lolheropro-arch/lab_ii_signal/mini_project/README.md

# Mini Shazam — ระบบจำเพลงจากเสียง (ESP32 + FPGA + Python)

ฟังเสียงเพลงจากไมค์ 5–10 วินาที แล้วบอกว่าเป็นเพลงอะไร และกำลังเล่นอยู่ที่นาทีไหนของเพลง
ใช้หลัก **Audio Fingerprinting** ตามเปเปอร์ของ Avery Wang (ผู้ร่วมก่อตั้ง Shazam), ISMIR 2003

```
ไมค์ ─► FPGA (สุ่ม 42 kS/s) ─► ESP32 ─USB─► Python: fingerprint ─► ค้นในฐานข้อมูล ─► ชื่อเพลง
```

---

## โครงสร้างไฟล์

| ไฟล์ | ทำหน้าที่ |
|---|---|
| `config.py` | **ค่าตั้งทั้งหมด** (พอร์ต, baud rate, sample rate, พารามิเตอร์อัลกอริทึม) แก้ที่นี่ที่เดียว |
| `fingerprint.py` | หัวใจ DSP: เตรียมสัญญาณ → Spectrogram → หาจุดยอด → สร้าง hash |
| `database.py` | เก็บ hash ลง SQLite และค้นหาเพลงด้วย offset histogram |
| `audio_input.py` | รับเสียง 2 แบบ: ไมค์ผ่าน FPGA + ESP32 (Serial), ไฟล์ทดสอบ |
| `hum.py` | โหมดฮัมเพลง: จับ pitch และเทียบทำนอง |
| `melodies.py` | โน้ตของทำนองอ้างอิงในโหมดฮัม |
| `app.py` | **โปรแกรมหลัก (GUI)** |
| `experiment.py` | ทดลองวัดความแม่นยำอัตโนมัติ ได้ตาราง CSV + กราฟไว้ใส่รายงาน |
| `fpga/` | โปรเจกต์ Quartus ของ Mini Shazam (สำเนาแยกจาก `task3/`) เปิด `task3_audio.qpf` |
| `esp32/` | sketch ของ Mini Shazam (สำเนาแยกจาก `task3/`) |
| `songs/` | ใส่ไฟล์เพลงที่นี่ |
| `fingerprints.db` | ฐานข้อมูล (สร้างให้อัตโนมัติ ลบทิ้งได้ถ้าอยากเริ่มใหม่) |

---

## ติดตั้ง (ทำครั้งเดียว)

ต้องมี Python 3.9 ขึ้นไป

```bash
pip install -r requirements.txt
```

- **Windows:** tkinter มากับ Python อยู่แล้ว
- **Linux:** ถ้าเจอ `No module named tkinter` ให้ติดตั้งเพิ่ม `sudo apt install python3-tk`
- ไฟล์ `.m4a` ต้องมี [ffmpeg](https://ffmpeg.org/) ในเครื่อง (mp3/wav/flac ไม่ต้อง)

## วิธีใช้

1. คัดลอกไฟล์เพลงลงโฟลเดอร์ `songs/` (ชื่อไฟล์ = ชื่อเพลงที่จะแสดง)
2. รัน `python app.py`
3. กด **"เพิ่มเพลงทั้งหมดในโฟลเดอร์ songs/"** (ครั้งแรกใช้เวลาเพลงละไม่กี่วินาที)
4. เลือกแหล่งเสียง แล้วกด **"ฟังและค้นหาเพลง"**

| แหล่งเสียง | ใช้เมื่อ |
|---|---|
| ไฟล์ทดสอบ | ทดสอบอัลกอริทึมโดยไม่ต้องต่ออะไร — สุ่มตัดช่วงจากไฟล์ และใส่ noise ได้ (ช่อง SNR, เว้นว่าง = ไม่ใส่) |
| ESP32 (USB-Serial) | ใช้งานจริง: ไมค์ → FPGA → ESP32 → คอม — เลือกพอร์ตจาก dropdown (กด ↻ เพื่อรีเฟรช) |

### ฟังเสียงที่อัดและลดเสียงพื้นหลัง
- ปุ่ม **"เล่นเสียงที่อัด"** เล่นเสียงล่าสุดผ่านลำโพง กดซ้ำเพื่อหยุด (เปิดได้หลังอัดหรือตัดคลิปแล้ว)
- ช่อง **"ลดเสียงพื้นหลัง"** มีผลตอนกดเล่นและตอนค้นหา ติ๊กแล้วกดเล่นซ้ำเพื่อเทียบเสียงก่อน/หลังได้ทันที
- ไมค์ตัวเดียว**วัดระยะไม่ได้** โปรแกรมจึงใช้ความดังแทนระยะ: ลดเสียงที่ดังสม่ำเสมอ (พัดลม, เสียงจอแจ) และช่วงที่เบากว่าช่วงดังเกิน `NEAR_GATE_DB` แต่แยกเสียงคนพูดหรือเพลงอื่นที่ดังพอกันออกไม่ได้ ต้องวางแหล่งเสียงให้ใกล้ไมค์ที่สุด

### เทียบกับเพลง candidate
- กราฟด้านขวาเลื่อนลงได้ด้วย scrollbar หรือล้อเมาส์ ใต้ Offset histogram คือ waveform และ spectrogram ของเพลง candidate ใช้แกนเวลาเดียวกับคลิปที่อัด
- เลือกเพลงในช่อง **"เทียบกับเพลง candidate"** เพื่อดูเพลงอื่นในอันดับ (สูงสุด 5 เพลงที่มี hash ตรง)
- ปุ่ม **"เล่นท่อนที่คล้ายในเพลง"** เล่นท่อนตามตำแหน่ง offset ที่คะแนนสูงสุดของเพลงนั้น กดปุ่มนี้สลับกับ "เล่นเสียงที่อัด" เพื่อฟังเทียบได้ทันที
- ไฟล์เพลงต้องอยู่ในโฟลเดอร์ `songs/` และชื่อตรงกับในฐานข้อมูล

### โหมดฮัมเพลง
- กด **"ฮัมแล้วค้นหาเพลง"** แล้วฮัมระหว่างที่โปรแกรมอัด (ความยาวตามช่องฟังนาน) ไม่ต้องตรงคีย์ และเร็วหรือช้ากว่าเดิมได้ราว 2 เท่า
- โหมดนี้จับ pitch ด้วย pYIN แล้วเทียบกับทำนองใน `melodies.py` ด้วย DTW จึงไม่ได้ใช้ฐานข้อมูล fingerprint ถ้าเพิ่มเพลง ต้องเพิ่มโน้ตในไฟล์นี้ด้วย
- ค่าความคล้ายคือ 100 × (1 − ค่าคลาดเฉลี่ย ÷ `HUM_COST_CAP`) ปรับเกณฑ์ได้ที่ `HUM_MIN_SIMILARITY` และ `HUM_MIN_MARGIN` ใน `config.py`

### กรองเสียงแอร์
- ช่อง **"กรองเสียงแอร์"** เปิดเป็นค่าเริ่มต้น ใช้ตอนกดเล่นเสียงและโหมดฮัม ติ๊กออกแล้วกดเล่นซ้ำเพื่อเทียบได้
- ตัวกรองเก็บช่วง 120–4000 Hz และตัดความถี่ที่ดังค้างตลอดคลิป (`FILTER_*` ใน `config.py`) จึงลดเสียงซ่าและเสียงทุ้มได้ แต่เสียงลมแอร์ที่อยู่ช่วงเดียวกับเสียงเพลงยังเหลืออยู่
- การจำเพลงจาก fingerprint ไม่ใช้ตัวกรองนี้ เพราะเมื่อทดสอบแล้วคะแนนลดลงและไม่ได้ตอบถูกมากขึ้น

### อ่านกราฟใน GUI
1. **Waveform** — เสียงที่อัดได้ (ถ้าแบนติดขอบ = clip → ลด gain ไมค์)
2. **Spectrogram + จุดฟ้า** — จุดยอดที่ใช้เป็นลายนิ้วมือ เส้นประ = ช่วงความถี่ที่ใช้ (300–3800 Hz)
3. **Offset histogram** — ถ้าเจอเพลง จะมี **แท่งเดียวสูงโด่ง** ตรงตำแหน่งในเพลง ถ้าไม่เจอจะกระจายเตี้ย ๆ

---

## รูปแบบข้อมูลจาก ESP32

ใช้ frame ของ Task 3 (`task3_esp32_bridge.ino`) โดย **ไม่ต้องแก้ FPGA หรือ sketch** แต่ละ frame ยาว 2070 ไบต์:

```
offset 0     sync  AA 55 33 CC
offset 4     seq (uint16)    offset 6  n (uint16)    offset 8  flags (uint8)
offset 20    sample 1024 ตัว แบบ uint16 little-endian (ค่า ADC 12-bit)
offset 2068  checksum = ผลรวม sample mod 2^16
```

Frame ที่ checksum ไม่ผ่านจะถูกข้าม และบล็อกที่หายจะเติมด้วยค่า DC ตามเลข `seq` เพื่อไม่ให้เวลาเลื่อน

ค่าที่เกี่ยวข้องใน `config.py`:

| ค่า | ความหมาย |
|---|---|
| `INPUT_FS` | sample rate ที่บอร์ดส่งมา (42000) ต้องตรงกับ `FS_HZ` ของ FPGA — DC offset จะถูกลบให้อัตโนมัติ |
| `BLOCK_SIZE` | จำนวน sample ต่อบล็อก (1024) |
| `SYNC_BYTES` | 4 ไบต์แรกของทุก frame |
| `FRAME_HEADER_BYTES` | ความยาว header รวม sync (20) |
| `SAMPLE_DTYPE` | `"<u2"` = uint16 |
| `BAUD_RATE` | ต้องตรงกับ `Serial.begin()` (921600) |

---

## โค้ดฮาร์ดแวร์และ sample rate

Mini Shazam ใช้โค้ด FPGA และ ESP32 ใน `fpga/` และ `esp32/` ของโฟลเดอร์นี้ แก้ได้โดยไม่กระทบ `task3/`

FPGA สุ่มที่ 42 kS/s (`FS_HZ` ใน `fpga/task3_audio.qsf` ความถี่จริงประมาณ 42,017 Hz เพราะ 50 MHz หารไม่ลงตัว) แล้ว Python ลดเหลือ 8 kHz (`FS` ใน `config.py`) ก่อนทำ fingerprint และลดเหลือ 16 kHz (`PLAY_FS`) ตอนกดเล่นเสียง

เลือก 42 kS/s จากการฟังแบบไม่รู้เฉลยเทียบกับ 32 kS/s วงจรไม่มีตัวกรอง anti-aliasing แบบ analog เมื่อสุ่มที่ 16 kS/s สัญญาณรบกวนแถว 13.7 kHz พับลงมาที่ 2.3 kHz ซึ่งอยู่ในช่วงที่ใช้จำเพลง การเพิ่ม sample rate ลดส่วนนี้ได้ แต่สัญญาณรบกวนส่วนที่สูงกว่า Nyquist ยังพับลงมาได้ ต้องใช้ตัวกรอง analog จึงจะกันได้จริง การวัดตอนเงียบที่ปิดแอร์ระหว่าง 32 กับ 42 kS/s แทบไม่ต่างกัน

ที่ 42 kS/s ใช้ USB ประมาณ 85 kB/s จากเพดานราว 92 kB/s ของ 921600 baud จึงเหลือระยะเผื่อน้อย ถ้าเปลี่ยนค่า ต้องแก้ `FS_HZ`, `FS_NOMINAL` ใน sketch และ `INPUT_FS` ให้ตรงกัน

ถ้าถอดไฟ DE10-Lite ต้องโปรแกรม `fpga/output_files/task3_audio.sof` ใหม่ และ compile ก่อนถ้ายังไม่มีไฟล์นี้

---

## ทดลองสำหรับรายงาน

```bash
python experiment.py                                         # ค่าเริ่มต้น
python experiment.py --lengths 2 5 10 --snr none 10 5 0 -5 --trials 30
python experiment.py --negatives other_songs/                # ทดสอบเพลงที่ "ไม่มี" ในฐานข้อมูล
```

ได้ไฟล์ `results/experiment_<เวลา>.csv` และกราฟ `.png` (Accuracy vs SNR แยกตามความยาวคลิป)

**ไอเดียการทดลองเพิ่มเติม** (ทำผ่าน GUI)
- เปิดเพลงจากลำโพงมือถือ vs ลำโพงคอม
- ระยะห่างลำโพง–ไมค์ 0.5 / 1 / 2 เมตร
- มีคนพูดแทรก / เปิดพัดลม
- เทียบไมค์ MAX4466 (analog) กับ INMP441 (I²S)

---

## ปรับจูนพารามิเตอร์ (`config.py`)

> ⚠️ แก้ค่าในหมวด "Fingerprint" แล้ว **ต้องกดล้างฐานข้อมูลและเพิ่มเพลงใหม่** เพราะ hash จะเปลี่ยน

| อาการ | ลองปรับ |
|---|---|
| เพลงที่ไม่มีในฐานข้อมูล แต่ระบบตอบว่าเจอ | เพิ่ม `MIN_RATIO` (เช่น 3–4) |
| เพลงที่มีอยู่ แต่หาไม่เจอเมื่อเสียงรบกวนเยอะ | ลด `MIN_RATIO` (เช่น 2), เพิ่ม `RECORD_SECONDS` |
| จุดยอดน้อยเกินไป (เห็นจุดฟ้าน้อย) | ลด `PEAK_MIN_DB` หรือลด `PEAK_NEIGHBORHOOD` |
| ฐานข้อมูลใหญ่/ช้า | เพิ่ม `PEAK_MIN_DB`, ลด `FAN_OUT` |

## แก้ปัญหาที่พบบ่อย

| ปัญหา | สาเหตุ / วิธีแก้ |
|---|---|
| `ไม่ได้รับ frame ที่ถูกต้อง` | baud rate ไม่ตรง, `SYNC_BYTES` ไม่ตรงกับ sketch, หรือ Serial Monitor ของ Arduino IDE เปิดค้างอยู่ (ต้องปิด) |
| `Permission denied: /dev/ttyUSB0` (Linux) | `sudo usermod -a -G dialout $USER` แล้ว logout/login |
| Waveform มีแต่สัญญาณรบกวน / เสียงเพี้ยน | `SAMPLE_DTYPE` หรือ `INPUT_FS` ไม่ตรงกับที่บอร์ดส่ง |
| Waveform แบนติดขอบ | เสียงดังเกิน → ลด gain ไมค์ หรือลดเสียงลำโพง |

---

## หลักการโดยย่อ (สำหรับอธิบายตอนนำเสนอ)

1. **Spectrogram** — STFT ด้วย Hann window, N = 1024 ที่ 8 kHz → ความละเอียด 7.8 Hz, 1 เฟรม = 32 ms
2. **Constellation map** — เก็บเฉพาะจุดที่ดังที่สุดในพื้นที่รอบตัว จุดพวกนี้ทนต่อ noise
3. **Combinatorial hashing** — จับคู่จุดยอด: `hash = (f1, f2, Δt)` → ไม่ขึ้นกับความดังและตำแหน่งเวลา
4. **Offset voting** — hash ที่ตรงกันของเพลงที่ถูกจะมี `t_เพลง − t_คลิป` เท่ากันหมด → histogram มีแท่งเดียวสูงโด่ง
5. **ตัดสินผล** — ต้องได้คะแนน ≥ `MIN_MATCHES` และมากกว่าคู่แข่ง ≥ `MIN_RATIO` เท่า

อ้างอิง: A. Wang, "An Industrial-Strength Audio Search Algorithm," *Proc. ISMIR*, 2003.
