lolheropro-arch/lab_ii_signal/mini_project/SLIDE_BRIEF.md

# Mini Shazam: ข้อมูลสำหรับทำสไลด์

เอกสารนี้สำหรับ agent ที่จะทำสไลด์นำเสนอ ใช้ตัวเลขตามนี้ และคงคำเตือนเรื่องความน่าเชื่อถือไว้

## กติกาสำหรับคนทำสไลด์

- ภาษาในสไลด์: ไทย ศัพท์เทคนิคเป็นอังกฤษได้
- โฟกัส: **การค้นหาเพลงจากเสียงเพลงที่เปิดจริง**
- **ห้ามพูดถึงโหมดฮัมเพลง** ยังอยู่ระหว่างพัฒนา แม้จะเห็นไฟล์ `hum.py` และ `melodies.py` ในโฟลเดอร์
- ระบุให้ชัดว่าตัวเลขไหน **วัดจากบอร์ดจริง** และตัวเลขไหน **จำลอง**
- ผลจากบอร์ดส่วนใหญ่เป็นการวัดรอบเดียวหรือไม่กี่รอบ ห้ามเขียนเป็น "ความแม่นยำ X%" ของระบบจริง
- ห้ามเขียนว่า "ไมค์ 4 ตัวลด noise ได้ดี" ผลที่วัดไม่ได้สนับสนุนข้อนี้ ดูหัวข้อการทดลอง

## 1. โปรเจกต์นี้คืออะไร

**Mini Shazam** คือระบบจำเพลงจากเสียงที่เปิดให้ไมค์ฟัง ได้แรงบันดาลใจจากแอป Shazam เลยอยากลองทำเอง โดยรับเสียงผ่านฮาร์ดแวร์ของ Lab และแสดงผลบน Python GUI

ผู้ใช้เปิดเพลงใกล้ไมค์แล้วกดปุ่ม ระบบจะตอบชื่อเพลงและตำแหน่งในเพลง พร้อมกราฟเปรียบเทียบ และเล่นเสียงที่อัดหรือท่อนเพลงที่คล้ายกันให้ฟังเทียบได้

โจทย์ Mini Project กำหนดให้ใช้ข้อมูลที่สตรีมจากฮาร์ดแวร์ และต้องทำมากกว่าการแสดงกราฟ FFT หรือ spectrogram ทั่วไป

## 2. สิ่งที่ใช้

| ส่วน | รายละเอียด |
|---|---|
| ไมค์ | โมดูลไมค์ analog ปรับ gain ได้ ไฟเลี้ยง 3.3 V ไบแอสเอาต์พุตประมาณ 1.65 V |
| ADC | MCP3201 ความละเอียด 12 บิต อ่านด้วย SPI ที่ 800 kHz |
| FPGA | Terasic DE10-Lite (MAX 10, `10M50DAF484C7G`) ภาษา VHDL บน Quartus Prime 20.1 |
| MCU | ESP32-S3 UNO ใช้ Arduino core และ FreeRTOS |
| ส่งเข้าคอม | USB-serial ผ่าน CH340 ที่ 921600 baud |
| ซอฟต์แวร์ | Python: NumPy, SciPy, librosa, pyserial, Matplotlib, Tkinter, SQLite |

## 3. เส้นทางข้อมูล

```
ไมค์ ─► ตัวต้านทาน ─► MCP3201 ─► FPGA ─► SPI ─► ESP32-S3 ─► USB ─► Python GUI
                     12 บิต   ping-pong  1 MHz    คิว 6 บล็อก  921600  fingerprint + SQLite
```

| ค่า | ปัจจุบัน |
|---|---|
| ตั้งค่า Sample rate | 42 kS/s (`FS_HZ` ใน `fpga/task3_audio.qsf`) |
| Sample rate จริงตามการหาร | ประมาณ 42,017 S/s เพราะ 50 MHz หาร 42,000 ไม่ลงตัว |
| ขนาดบล็อก | 1024 sample (ประมาณ 24.4 ms ต่อบล็อก) |
| SPI FPGA→ESP32 | Mode 0, 1 MHz, 2060 ไบต์ต่อบล็อก (ใช้ประมาณ 16.5 ms) |
| USB ESP32→คอม | 2070 ไบต์ต่อบล็อก ใช้ราว 85 kB/s จากเพดานประมาณ 92 kB/s |
| Python | ลดเหลือ 8 kHz ก่อน fingerprint และ 16 kHz ตอนเล่นเสียง |

Task 3 ใช้ 16 kS/s แต่ Mini Project แยกโค้ดออกมาและเลือก sample rate ตามผลทดลองได้เอง

หมายเหตุ: คอมเมนต์หัวไฟล์ FPGA และ sketch ยังเขียน 16 kS/s, SPI 4 MHz หรือ MCP3202 ตามของเดิม ให้ยึดตารางนี้ และ ESP32 บนบอร์ดยังไม่ได้ upload sketch รุ่นที่ตั้งค่า header เป็น 42000 ซึ่ง Mini Shazam ไม่ได้อ่านค่านี้จึงยังทำงานได้

## 4. Hardware timer, DMA และ ping-pong buffer

| เทคนิค | ใช้ไหม | อยู่ตรงไหน |
|---|---|---|
| **จังหวะสุ่มจากฮาร์ดแวร์** | **ใช้** | `sample_tick_gen.vhd` นับคล็อก 50 MHz เป็นวงจรใน FPGA ไม่ได้พึ่งซอฟต์แวร์ |
| **Ping-pong buffer** | **ใช้** | `audio_block_buffer.vhd` BRAM 2 ธนาคาร ธนาคารละ 1024 ค่า |
| **Hardware timer ของ MCU** | **ไม่ใช้** | ESP32 ไม่ได้เป็นตัวสุ่มเสียง Fs จึงไม่ขึ้นกับจังหวะซอฟต์แวร์ของ ESP32 |
| **DMA ที่เขียนสั่งเองในโค้ด** | **ไม่มี** | sketch ใช้ `SPI.transferBytes()` ตรงๆ และไม่ได้ตั้งค่า DMA เอง |
| **Interrupt และ RTOS** | **ใช้** | ขา DRDY ปลุกงาน SPI ผ่าน ISR และ semaphore แยกงาน SPI ไว้ core 0 กับงาน USB ไว้ core 1 |
| **บัฟเฟอร์ฝั่ง ESP32** | **ใช้** | pool 6 บล็อก พร้อมคิว `freeQ` และ `fullQ` |

Ping-pong ทำงานแบบนี้: ADC เขียนธนาคารหนึ่งจนเต็ม แล้วสลับไปอีกธนาคาร ส่วน SPI อ่านธนาคารที่เขียนจบแล้ว ฝั่งเขียนไม่ต้องหยุดรอฝั่งอ่าน จังหวะสุ่มจึงไม่ถูก SPI รบกวน

## 5. ยืนยันว่าข้อมูลครบและไม่เสีย

| ชั้น | สิ่งที่ตรวจ | ถ้าเจอปัญหา |
|---|---|---|
| **FPGA** | ส่ง status `0xC3`, sync `0xA55A`, `SEQ`, `FLAGS`, จำนวน `N`, checksum และนับ `DROPS` | ถ้าบล็อกค้าง จะนับ drop และ `SEQ` ยังเดินต่อ |
| **ESP32 (รับจาก SPI)** | ตรวจ status, sync, `N`, บิต valid และ checksum | ไม่ส่งบล็อกนั้นต่อ และนับ `spi_errs` |
| **ESP32 (ส่งออก USB)** | ใส่ sync `AA 55 33 CC`, seq, ตัวนับ error/drop, เวลา และ checksum | ถ้าคิวเต็ม จะนับ `esp_drops` |
| **Python** | หา sync ใหม่เอง ตรวจความยาวและ checksum | ทิ้ง frame เสีย |
| **Python (ลำดับ)** | ตรวจเลข `seq` | ถ้าบล็อกหาย เติมด้วยค่า DC เพื่อไม่ให้เวลาเลื่อน |

**Checksum** คือผลรวม sample ทั้งบล็อก mod 2^16 จับ bit error ทั่วไปได้ แต่ไม่ใช่ CRC จึงจับกรณีสลับลำดับ sample ไม่ได้

**ผลตรวจลิงก์:** บอร์ดจริงไม่มีบล็อกหายใน `--check 10` ที่ 16 kS/s ส่วนที่ 42 kS/s พบบล็อกหาย 5 จาก 1,522 (ประมาณ 0.33%) และมีรอบหนึ่ง 4 จาก 300 จึงควรพูดว่าเหลือระยะเผื่อ USB น้อย

## 6. หลักการจำเพลง

ขั้นตอนเป็นแนวเดียวกับ audio fingerprinting ของ Shazam:

1. **เตรียมเสียง:** ลบ DC, ลดเหลือ 8 kHz, normalize
2. **Spectrogram:** STFT หน้าต่าง Hann, NFFT 1024 (7.8 Hz ต่อช่อง), HOP 256 (32 ms ต่อเฟรม)
3. **Constellation map:** หาจุดยอดเฉพาะพื้นที่ในช่วง 300–3800 Hz และต้องดังกว่า median อย่างน้อย 10 dB
4. **Hash:** จับคู่จุดยึดกับจุดถัดไปไม่เกิน 10 จุด เก็บ `(f1, f2, dt)` ระยะเวลาห่างไม่เกิน 63 เฟรม (ประมาณ 2 วินาที)
5. **ค้นในฐานข้อมูล:** หา hash ที่ตรงกันใน SQLite
6. **Offset histogram:** คำนวณ `offset = t_เพลง − t_คลิป` ถ้าเป็นเพลงเดียวกัน hash จำนวนมากจะกองที่ offset เดียว

### การให้คะแนน

| ค่า | ความหมาย | เกณฑ์ |
|---|---|---|
| `score` | จำนวน hash ที่ offset ตรงกัน (ยอมคลาด ±1 เฟรม) | ≥ 12 |
| `ratio` | `score ÷ คู่แข่ง` | ≥ 2.5 |

คู่แข่งคือเพลงอันดับ 2 หรือยอดอื่นในเพลงเดียวกัน โดยตัด 4 ยอดสูงสุดออกก่อน เพราะอาจเป็นท่อนซ้ำ

ต้องผ่านทั้งสองข้อ จึงจะตอบชื่อเพลง คะแนนไม่ใช่เปอร์เซ็นต์ และไม่มีเพดาน 100 คลิปที่ยาวกว่ามักได้คะแนนสูงกว่า

**ระบบไม่ได้เทียบ waveform ตรงๆ** กราฟ waveform และ spectrogram ของ candidate มีไว้ให้คนดูเท่านั้น

### ฟีเจอร์ใน GUI ที่ควรโชว์

- กราฟ waveform, spectrogram + จุดยอด, offset histogram
- กราฟท่อนเพลง candidate ใช้แกนเวลาเดียวกับคลิป และซ้อนจุดยอดของเพลงกับเสียงที่อัด
- เลือก candidate ได้ และเล่นเสียงที่อัดสลับกับท่อนที่คล้ายได้

## 7. ผลการค้นหาเพลง

### วัดจากบอร์ดจริง (เปิดเพลงจากมือถือ)

ฐานข้อมูลมี 4 เพลง: Für Elise, Eine Kleine Nachtmusik, สามัคคีชุมนุม, เพลงอวยพรวันเกิด เพลงที่ทดสอบในตารางนี้คือ Für Elise

| เงื่อนไข | ความยาวคลิป | score | ratio | ผล |
|---|---|---|---|---|
| 32 kS/s | 15 วินาที | 1311 | 11.1 | ถูก |
| 32 kS/s | 8 วินาที | 269 | 6.4 | ถูก |
| 42 kS/s | 15 วินาที | 1065 | 8.1 | ถูก |
| 42 kS/s | 8 วินาที | 651 | 10.2 | ถูก |
| 42 kS/s, ไมค์ 4 ตัว | 10 วินาที | 254 | 4.9 | ถูก |
| 42 kS/s, ไมค์ 1 ตัว | 10 วินาที | 233 | 5.5 | ถูก |

ตัวเลขในตารางนี้มาจากคนละท่อนเพลงและคนละระดับเสียง จึง **ห้ามนำมาเทียบว่า sample rate ไหนจำเก่งกว่า**

**ตัวเปรียบเทียบเชิงลบ (วัดจริง):** เสียงห้องเปล่าได้ score 4–5 และ ratio 1.0–1.25 ระบบตอบว่าไม่พบ ส่วนเพลงจากลำโพงคอมซึ่งเข้าไมค์เบา อันดับ 1 เป็นเพลงถูก (score 24–109) แต่ ratio แค่ 1.7–1.9 จึงตอบว่าไม่พบ

### จำลอง (คลิป 8 วินาทีตัดจากไฟล์ ไม่ผ่านไมค์)

White noise ชุดละ 100 คลิป:

| SNR | ตอบถูก | ตอบผิดอย่างมั่นใจ |
|---|---|---|
| ไม่ใส่ noise | 100 | 0 |
| 5 dB | 100 | 0 |
| 0 dB | 98 | 0 |
| −5 dB | 92 | 0 |

เพลงที่ไม่มีในฐานข้อมูล (leave-one-out, SNR ไม่ใส่/5/0 dB รวม 300 คลิป): ตอบผิด 0 คลิป

เสียงแอร์จริงที่อัดไว้ผสมกับคลิปเพลง ชุดละ 16 คลิป:

| SNR | ตอบถูก |
|---|---|
| 5 dB | 16 |
| 0 dB | 16 |
| −6 dB | 16 |

## 8. การทดลองและข้อสรุป

### 8.1 ไมค์ 1 ตัวเทียบ 4 ตัว

**ไอเดีย:** ต่อไมค์ 4 ตัวผ่านตัวต้านทาน 5.1 kΩ เท่ากันเข้าจุดเดียว แรงดันที่จุดรวมคือค่าเฉลี่ยตามทฤษฎีบท Millman โค้ดจึงไม่ต้องเปลี่ยน เพราะ ADC ยังเห็นแรงดันเส้นเดียว

**ที่คาดไว้:** เสียงรบกวนที่ไม่สัมพันธ์กันควรลดได้สูงสุดประมาณ 6 dB ส่วนเสียงความถี่ต่ำจะหักล้างยาก เพราะความยาวคลื่นที่ 300–1000 Hz คือ 34–114 ซม. ใหญ่กว่าระยะแถวไมค์ราว 15 ซม.

**ผลจากบอร์ด (10 วินาที เปิดเพลงจากมือถือ):**

| ค่า | 4 ไมค์ | 1 ไมค์ |
|---|---|---|
| score / ratio | 254 / 4.9 | 233 / 5.5 |
| rms รวม | 16.4 | 58.3 |
| แถบ 300–1000 Hz | 6.8 | 48.9 |
| แถบ 1000–2000 Hz | 10.7 | 21.9 |
| แถบ 2000–3800 Hz | 2.2 | 7.3 |
| แถบ 4000–8000 Hz | 4.0 | 4.7 |
| แถบ 8000–16000 Hz | 4.1 | 4.3 |

อีกรอบที่ต่อเนื่องกัน ช่วงละประมาณ 5 วินาที: 4 ไมค์ score 167, ratio 3.0 และ 1 ไมค์ score 248, ratio 19.1

**ข้อสรุปที่เขียนได้:**
- จำเพลงได้ทั้งสองแบบ และรอบ 10 วินาทีคะแนนใกล้กัน
- รอบนี้ 4 ไมค์ **ไม่ได้ลดเสียงซ่าอย่างชัดเจน** และสัญญาณเพลงในรอบนี้เบากว่าไมค์เดี่ยวมาก

**ห้ามสรุปเกินข้อมูล:** ยังไม่รู้สาเหตุที่ 4 ไมค์เสียงเบากว่า อาจเกิดจากเสียงถึงไมค์ไม่พร้อมกัน, gain ไม่เท่ากัน หรือไมค์เดี่ยวอยู่ใกล้ลำโพงกว่า และยังไม่ได้ปรับ gain ทีละตัว ท่อนเพลงของแต่ละรอบก็ต่างกัน

### 8.2 เพิ่ม Sampling rate

**ปัญหา:** วงจรไม่มีตัวกรอง anti-aliasing แบบ analog สัญญาณที่สูงกว่า Nyquist จะพับลงมา

**หลักฐานการพับความถี่ (วัดจริง):**

| ความถี่จริงที่เห็นตอน 32 kS/s | ตอน 16 kS/s พับไปที่ | วัดได้ตอน 16 kS/s |
|---|---|---|
| ประมาณ 13.7 kHz | ประมาณ 2.3 kHz | 2334 Hz |
| ประมาณ 9.1 kHz | ประมาณ 6.9 kHz | 6832 Hz |

**ตอนเงียบ ก่อนทดลองปิดแอร์ (หลังลดเหลือ 16 kHz เพื่อเทียบกัน แต่ละค่ามาจากคนละช่วงเวลาและเสียงห้องเปลี่ยนได้):**

| แถบ | 16 kS/s | 32 kS/s | 40 kS/s |
|---|---|---|---|
| 2000–3800 Hz | 7.4–8.4 | 2.3–5.1 | 3.4–3.8 |
| 4000–6000 Hz | 7.4 | 6.4–7.3 | 4.9 |
| 6000–7800 Hz | 7.2–7.3 | 1.5–1.7 | 4.3 |

**ข้อสรุปที่เขียนได้:**
- จาก 16 เป็น 32 kS/s ลดเสียงรบกวนในช่วงจำเพลงได้ชัด เพราะสัญญาณความถี่สูงพับลงมาทับน้อยลง
- จาก 32 เป็น 40 kS/s เสียงรบกวนแค่ย้ายแถบ รวมแล้วไม่ดีขึ้นชัดเจน
- 42 kS/s ถูกเลือกจากการฟังแบบไม่รู้เฉลย 1 รอบเทียบ 32 kS/s ผู้ฟังให้ 42 kS/s ดีกว่า แต่สองไฟล์มีระดับเสียงต่างกัน (rms 21.2 กับ 16.0) ส่วนการวัดตอนปิดแอร์ สองค่านี้แทบเท่ากัน
- การเพิ่ม sample rate ช่วยเรื่อง aliasing ไม่ได้กำจัดเสียงรบกวนทั้งหมด และแลกกับระยะเผื่อ USB ที่น้อยลง

**เทียบระหว่างการทดลอง:** สำหรับเสียงรบกวนช่วงจำเพลง การเพิ่มจาก 16 เป็น 32 kS/s ให้ผลชัดกว่าการเปลี่ยนจาก 1 เป็น 4 ไมค์ ส่วนการเพิ่มความดังของเพลง รอบนี้ไมค์เดี่ยวดังกว่า ยังไม่ควรสรุปว่า sample rate หรือจำนวนไมค์ทำให้การจำเพลงแม่นขึ้น เพราะ score ยังเทียบกันข้ามรอบไม่ได้

### 8.3 ผลของแอร์

| ค่าตอนเงียบ 32 kS/s | เปิดแอร์ | ปิดแอร์ |
|---|---|---|
| rms รวม | 21–48 | 6.7–6.8 |
| แถบแถว 4.45–4.7 kHz | 4.8 | 0.3 |
| แถบแถว 13.6–13.9 kHz | 5.2 | 0.22 |
| ต่อแถบ 2 kHz ช่วง 2–16 kHz | 2–6.5 | 0.5–1.0 |

**ผลการฟังล่าสุดของผู้ทดลอง:** ไม่มีเสียงรบกวนรุนแรงแล้ว เหลือเล็กน้อยในระดับยอมรับได้ ควรนำเสนอว่าเป็นการประเมินด้วยการฟัง ไม่ใช่ค่าที่วัดได้

ปิดแอร์แล้วเสียงรบกวนช่วงสูงลดลงมากที่สุดในการทดลองทั้งหมด ยังไม่รู้ว่าเข้ามาทางเสียงหรือทางไฟฟ้า และไม่ได้เปิดกับปิดสลับหลายรอบ

เมื่อปิดแอร์ เสียงพูดห่างไมค์ 5 ซม. มีช่วงดังเทียบช่วงเบา 28.7 dB เทียบกับ 14 dB ในรอบก่อนปิดแอร์ แต่เป็นการพูดคนละครั้ง จึงเป็นแค่แนวโน้ม

### 8.4 ตัวกรองเสียงในโปรแกรม

- **ตัวกรองเสียงแอร์:** band-pass 120–4000 Hz + notch ความถี่ที่ดังค้าง ใช้เฉพาะตอนเล่นเสียง เสียงสูงกว่า 4 kHz ลดจาก 11.7–11.9 เหลือ 1.5 แต่แถบ 300–1000 Hz ไม่ลด
- **ไม่ใช้กับการจำเพลง:** ทดสอบแล้วคะแนนลดลงราว 40% และที่ SNR −6 dB ตอบถูกลดจาก 16 เป็น 14 ชุดละ 16 คลิป
- **ตัวเลือกลดเสียงแบบ spectral gating:** ผู้ใช้ฟังแล้วไม่ดีกว่า จึงปิดเป็นค่าเริ่มต้น

## 9. ปัญหาที่เจอและวิธีแก้

| ปัญหา | อาการ | สาเหตุ | วิธีแก้ |
|---|---|---|---|
| ข้อมูลเลื่อน 1 บิต | PC ไม่ได้รับ frame เลย | อ่าน `0xC3` เป็น `0x86` ESP32 ปฏิเสธทุกบล็อกแบบเงียบ | เลื่อนบิตกลับในฝั่ง ESP32 ต้นเหตุในฮาร์ดแวร์ยังไม่ยืนยันด้วย scope |
| ไม่รู้ว่าลิงก์ติดตรงไหน | ไม่มีข้อความใดๆ | Sketch ทิ้งข้อมูลเงียบๆ | เพิ่มบรรทัด `#ESP32 alive` รายงานสถานะ |
| รูปแบบ frame ไม่ตรง | โปรแกรมต่อกับบอร์ดไม่ได้ | Python คาด frame คนละแบบกับ Task 3 | เขียนตัวรับใหม่ พร้อม checksum และ `seq` |
| Error พอร์ต | ขึ้น Input/output error | โปรแกรมเลือก `/dev/ttyS31` | เรียงพอร์ต USB ขึ้นก่อน |
| เพลงมีท่อนซ้ำ | เจอเพลงถูกแต่ตอบว่าไม่พบ | ยอดท่อนซ้ำถูกนับเป็นคู่แข่ง | ไม่นับ 4 ยอดสูงสุดเป็นคู่แข่ง จำลองแล้วตอบถูกจาก 87 เป็น 100 ชุดละ 100 คลิป |
| FPGA ไม่ส่งข้อมูล | MISO อ่านได้ `0xFF` | `.sof` หายเมื่อถอดไฟ | โปรแกรมใหม่หลังเสียบไฟ |
| ค่า ADC ผิด | เฉลี่ย 84, ค่า 0 มาก, ฮัม 50 Hz | สายจากจุดรวมไมค์ไม่ได้ต่อเข้า IN+ | เพิ่มสาย ค่าเฉลี่ยกลับมาเป็น 2055 |
| ต่อ GND ผิด | ไฟลัดตอนต่อไมค์ 4 ตัว | สาย GND เสียบผิดตำแหน่ง | แก้สายแล้ววัดไฟ 3.3 V ปกติ ยังไม่พิสูจน์ว่าไมค์ทุกตัวไม่เสียหาย |
| เสียงจี่ | เสียงพูดฟังยาก | เสียงจากแอร์/ห้อง และการพับความถี่ | เพิ่ม sample rate, ปิดแอร์ และกรองตอนเล่นเสียง |

## 10. ข้อจำกัดและงานต่อ

- ฐานข้อมูลมีแค่ 4 เพลง ยังไม่รู้พฤติกรรมเมื่อฐานข้อมูลใหญ่
- ยังไม่ได้ทดสอบหลายเพลงและหลายรอบผ่านไมค์จริงเพื่อหาอัตราความแม่นยำ
- วงจรยังไม่มีตัวกรอง analog ก่อน ADC (แนวทางที่ยังไม่ทดสอบ: 10 nF ที่ขา IN+ ลง GND ตัดราว 7 kHz ตามการคำนวณ)
- USB เหลือระยะเผื่อน้อยที่ 42 kS/s
- การเลื่อน 1 บิตยังเป็นการแก้ที่อาการ ควรตรวจด้วย scope
- ไมค์ 4 ตัวยังไม่ได้ปรับ gain ทีละตัว

## ภาคผนวก: ค่าที่ทดลองทั้งหมด

ค่าแถบความถี่เป็น rms ในหน่วยค่า ADC (1 ค่า ≈ 0.8 mV) ใช้เลือกแสดงตามความเหมาะสม ค่าส่วนใหญ่มาจากการวัดรอบเดียว เสียงห้องอาจต่างกันระหว่างรอบ และบางรอบไม่ได้บันทึกสถานะแอร์ไว้

### A. ลิงก์ข้อมูล

| การทดสอบ | ผล |
|---|---|
| `--check 10` ที่ 16 kS/s | Fs_est 15999.76 S/s, block หาย 0, spi_err 0, esp_drop 0 |
| `--check 5` ที่ 16 kS/s หลังต่อไมค์ใหม่ | Fs_est 15999.75 S/s, block หาย 1 |
| อัตรารับที่วัดจากเวลาเครื่อง | 32 kS/s: 31,805–32,064, 40 kS/s: 39,878–39,880, 42 kS/s: 41,590–41,894 S/s |
| Block หาย 32 กับ 42 kS/s (รวม 4 รอบ) | 32 kS/s: 3/1,158, 42 kS/s: 5/1,522 |
| Block หาย 42 kS/s รอบอื่น | 1/328, 4/300 |

ค่าอัตรารับคิดจากเวลาที่คอมได้รับข้อมูล จึงคลาดเคลื่อนได้ และ block ที่หายทำให้ค่าต่ำลง ค่าอ้างอิงที่ตรงกว่าคือ Fs_est ของเครื่องมือตรวจลิงก์

### B. ไบแอสขาเข้า ADC

| สภาพ | ค่าเฉลี่ย | แรงดัน | ต่ำสุด–สูงสุด | หมายเหตุ |
|---|---|---|---|---|
| สายจุดรวมยังไม่ต่อ | 84 | 0.067 V | 0–646 | ค่า 0 พอดี 40.5%, 50 Hz เด่น 31.8% |
| ต่อสายแล้ว (4 ไมค์) | 2055 | 1.656 V | 1487–2595 | ค่า 0 พอดี 0% |

### C. โทนทดสอบผ่านลำโพงคอม → ไมค์ → ADC

| โทน | อ่านได้ | สูงกว่าพื้นเสียงของแถบนั้น |
|---|---|---|
| 1 kHz (16 kS/s) | 1000 Hz | 42.8 dB |
| 2 kHz (16 kS/s) | 2000 Hz | 40.1 dB |
| 3 kHz (16 kS/s) | 3000 Hz | 47.5 dB |
| 4 kHz (16 kS/s) | 4000 Hz | 51.8 dB |
| 6 kHz (16 kS/s) | 6000 Hz | 40.1 dB |
| 3 kHz (32 kS/s) | 3000 Hz | ไม่ได้คำนวณ |
| 3 kHz (42 kS/s) | 2999.3 Hz | ไม่ได้คำนวณ |

เป็นค่าแถบแคบ จึงดูดีกว่าคุณภาพเสียงจริงมาก ใช้ยืนยันความถี่และเส้นทางสัญญาณเท่านั้น

### D. Sampling rate ตอนเงียบ (ลดเหลือ 16 kHz ก่อนเทียบ)

| รอบ | Fs | rms รวม | 300–1000 | 1000–2000 | 2000–3800 | 4000–6000 | 6000–7800 |
|---|---|---|---|---|---|---|---|
| ชุด 1 รอบ 1 | 32k | 24.8 | 16.8 | 4.1 | 2.3 | 7.1 | 1.7 |
| ชุด 1 รอบ 2 | 16k | 23.0 | 13.9 | 6.5 | 7.4 | 7.4 | 7.2 |
| ชุด 1 รอบ 3 | 32k | 29.4 | 20.7 | 7.2 | 2.6 | 7.3 | 1.5 |
| ชุด 1 รอบ 4 | 16k | 41.5 | 33.0 | 11.8 | 8.4 | 7.4 | 7.3 |
| ชุด 2 รอบ 1 | 40k | 23.5 | 15.0 | 5.7 | 3.4 | 4.9 | 4.3 |
| ชุด 2 รอบ 2 | 32k | 48.0 | 41.3 | 11.8 | 5.1 | 6.5 | 1.7 |
| ชุด 2 รอบ 3 | 40k | 32.2 | 25.2 | 8.6 | 3.8 | 4.9 | 4.3 |
| ชุด 2 รอบ 4 | 32k | 21.1 | 12.8 | 5.7 | 2.6 | 6.4 | 1.7 |
| ชุด 3 รอบ 1 | 42k | 4.5 | 1.6 | 1.2 | 0.9 | 0.5 | 0.3 |
| ชุด 3 รอบ 2 | 32k | 5.0 | 1.6 | 1.2 | 0.9 | 0.5 | 0.3 |
| ชุด 3 รอบ 3 | 42k | 4.3 | 1.5 | 1.1 | 0.9 | 0.5 | 0.3 |
| ชุด 3 รอบ 4 | 32k | 7.9 | 1.6 | 1.2 | 0.9 | 0.5 | 0.3 |

ชุด 3 มีเสียงรบกวนต่ำมาก น่าจะปิดแอร์อยู่ แต่ไม่ได้ยืนยันสถานะแอร์

ตอน 32 kS/s พบความถี่เด่น 4.5–4.65 kHz และ 13.7–13.8 kHz ส่วนตอน 40 kS/s พบ 5.9, 6.8, 12.7, 13.6 และ 19.6 kHz ยอดที่ย้ายตาม sample rate ชี้ว่ามีสัญญาณสูงกว่า Nyquist พับลงมา

### E. เสียงพูด

| รอบ | rms รวม | ช่วงดังเทียบเบา | ต่อ 0.5 วินาที | ผลการฟัง |
|---|---|---|---|---|
| ไมค์เดี่ยว ห้องมีคน (16 kS/s) | 102 | 11 dB | 48–135 | ฟังไม่รู้เรื่อง |
| ไมค์เดี่ยว พูด 5 ซม. (16 kS/s) | 114.5 | 7.3 dB | 83–141 | ฟังไม่รู้เรื่อง |
| คลิปจากมือถือจ่อไมค์เดี่ยว ย้ายมาที่เงียบ (16 kS/s) | 549.4 | ไม่ได้คำนวณ | 19–1341 | **ฟังรู้เรื่อง** |
| 4 ไมค์ พูด (16 kS/s) | 83.8 | 14 dB | 36–160 | ฟังรู้เรื่อง มีเสียงซ่า |
| 4 ไมค์ ปิดแอร์ พูด (32 kS/s) | 92.0 | 28.7 dB | 8–173 | ไม่ได้บันทึกผลการฟัง |

### F. ไมค์เดี่ยวกับ 4 ไมค์ แบบ 15 วินาทีต่อเนื่อง

| ช่วง | rms | 300–1000 | 1000–2000 | 2000–3800 | 4000–8000 | 8000–16000 | score | ratio |
|---|---|---|---|---|---|---|---|---|
| 4 ไมค์ | 14.4 | 7.4 | 4.9 | 3.0 | 4.7 | 4.6 | 167 | 3.0 |
| ระหว่างถอดสาย | 14.4 | 6.5 | 5.9 | 3.2 | 4.5 | 4.6 | 169 | 2.7 |
| 1 ไมค์ | 24.6 | 18.2 | 11.1 | 3.6 | 4.7 | 4.6 | 248 | 19.1 |

### G. เปิดแอร์เทียบปิดแอร์ (32 kS/s, เงียบ)

| สภาพ | rms รวม | 20 ms p10/p50 | แถว 4.45–4.7 kHz | แถว 13.6–13.9 kHz |
|---|---|---|---|---|
| เปิด รอบ 1 | 48.0 | 17/32 | 4.77 | 5.18 |
| เปิด รอบ 2 | 21.1 | 14/18 | 4.76 | 5.21 |
| ปิด รอบ 1 | 6.8 | 5/7 | 0.29 | 0.22 |
| ปิด รอบ 2 | 6.7 | 5/6 | 0.30 | 0.22 |

ยืนยันว่าไมค์ยังต่ออยู่ตอนปิดแอร์ด้วยโทน 1 kHz: แถบนี้ขึ้นจากต่ำกว่า 2 เป็นราว 680

### H. ตัวกรองเสียงแอร์

| ไฟล์ | ไม่กรอง: score/ratio | กรอง: score/ratio |
|---|---|---|
| เพลง 4 ไมค์ | 254 / 4.9 | 158 / 4.3 |
| เพลง 1 ไมค์ | 233 / 5.5 | 138 / 5.5 |
| เพลงจากมือถือ 15 วินาที | 1065 / 8.1 | 571 / 8.3 |

| คลิปเพลง + เสียงแอร์จริง (16 คลิป) | ไม่กรอง: ถูก / score p50 | กรอง: ถูก / score p50 |
|---|---|---|
| SNR 5 dB | 16 / 725 | 16 / 550 |
| SNR 0 dB | 16 / 406 | 16 / 327 |
| SNR −6 dB | 16 / 164 | 14 / 152 |

| เสียงเงียบตอนเปิดแอร์ | ต่ำกว่า 120 Hz | 120–300 | 300–1000 | 1000–2000 | 2000–4000 | สูงกว่า 4000 Hz |
|---|---|---|---|---|---|---|
| ไม่กรอง รอบ 1 | 6.3 | 15.9 | 41.2 | 11.8 | 5.2 | 11.9 |
| กรอง รอบ 1 | 1.6 | 15.4 | 41.2 | 11.8 | 4.9 | 1.5 |
| ไม่กรอง รอบ 2 | 5.5 | 8.3 | 12.8 | 5.7 | 2.8 | 11.7 |
| กรอง รอบ 2 | 1.4 | 7.8 | 12.8 | 5.7 | 2.5 | 1.5 |

### I. ผลรวมการจำเพลงจากไฟล์ที่เกี่ยวกับการปรับปรุงกฎตัดสิน (จำลอง 100 คลิปต่อชุด)

| SNR | ตอบถูก ก่อนแก้ท่อนซ้ำ | ตอบถูก หลังแก้ |
|---|---|---|
| ไม่ใส่ noise | 87 | 100 |
| 10 dB | 73 | 100 |
| 5 dB | 79 | 100 |
| 0 dB | 71 | 98 |
| −5 dB | 67 | 92 |

ทั้งสองแบบตอบผิดอย่างมั่นใจ 0 คลิป และเสียงห้องจริง 4 ไฟล์ตอบไม่พบทั้งหมด

## 11. โครงสไลด์ที่แนะนำ

1. Mini Shazam คืออะไร และแรงบันดาลใจจาก Shazam
2. ภาพรวมระบบ: ไมค์ → ADC → FPGA → ESP32 → Python
3. การรับข้อมูล: Fs จาก FPGA, ping-pong, SPI, USB
4. ความถูกต้องของข้อมูล: checksum, sync, seq และการนับ drop
5. หลักการจำเพลง: spectrogram → จุดยอด → hash
6. การเทียบและให้คะแนน: offset histogram, `score`, `ratio`
7. หน้าจอโปรแกรมและการเปรียบเทียบ candidate
8. ผลการค้นหาเพลง
9. การทดลองไมค์ 1 ตัวเทียบ 4 ตัว
10. การทดลอง sampling rate และหลักฐาน aliasing
11. ผลของแอร์และตัวกรองเสียง
12. ปัญหาที่เจอและวิธีแก้
13. ข้อจำกัดและงานต่อ

## 12. ไฟล์อ้างอิง

| ไฟล์ | เนื้อหา |
|---|---|
| `fpga/sample_tick_gen.vhd` | สร้างจังหวะสุ่ม |
| `fpga/mcp3202_reader.vhd` | อ่าน MCP3201 |
| `fpga/audio_block_buffer.vhd` | Ping-pong buffer |
| `fpga/spi_slave_block.vhd` | SPI slave และรูปแบบ frame |
| `esp32/task3_esp32_bridge/task3_esp32_bridge.ino` | ส่งข้อมูลจาก SPI ไป USB |
| `audio_input.py` | รับ frame, เล่นเสียง และกรองเสียง |
| `fingerprint.py` | Spectrogram, จุดยอด และ hash |
| `database.py` | SQLite, offset histogram และการให้คะแนน |
| `app.py` | GUI |
| `config.py` | ค่าตั้งทั้งหมด |

ถ้าต้องการภาพหน้าจอ ให้ขอจากเจ้าของโปรเจกต์ เพราะยังไม่ได้เก็บไว้ในโฟลเดอร์นี้
