lolheropro-arch/lab_ii_signal/docs/circuit/task1_circuit.jpg

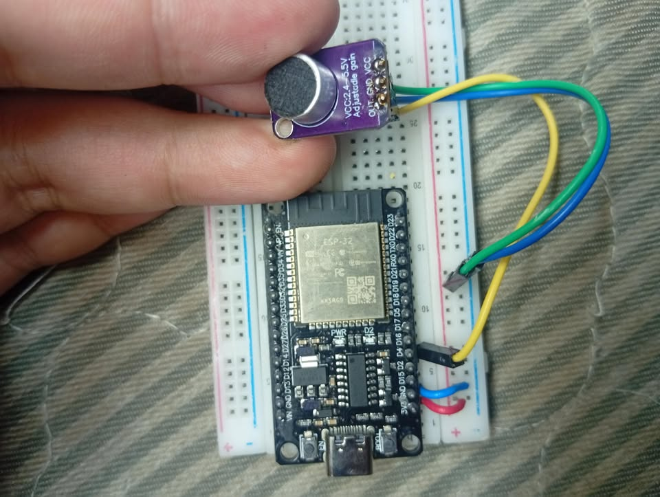
docs/circuit/task1_circuit.jpg
