lolheropro-arch/lab_ii_signal/docs/circuit/task2_circuit.jpg

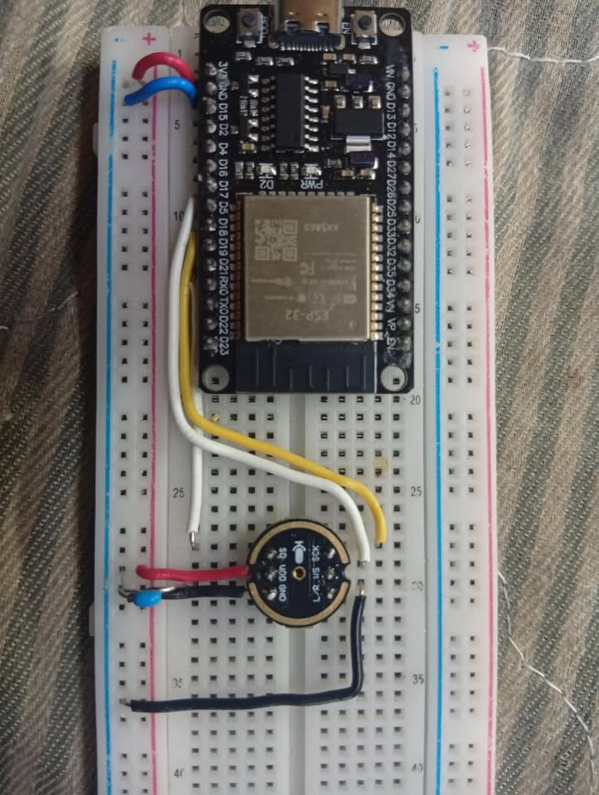
docs/circuit/task2_circuit.jpg
