lolheropro-arch/lab_ii_signal/task3/docs/img/host_1k.png

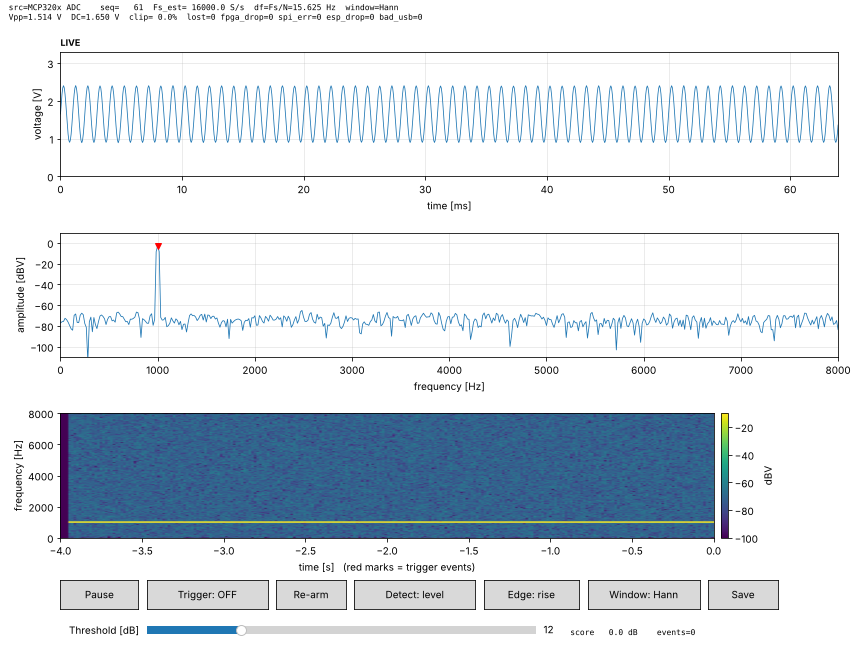
task3/docs/img/host_1k.png
