lolheropro-arch/lab_ii_signal/task3/docs/img/host_9k_alias.png

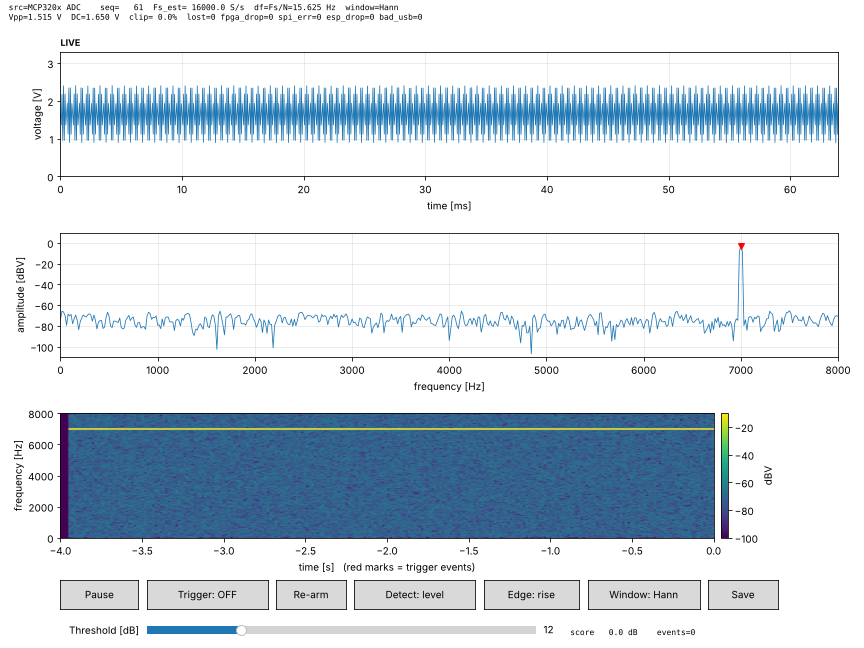
task3/docs/img/host_9k_alias.png
