lolheropro-arch/lab_ii_signal/task3/docs/img/host_1100_hann.png

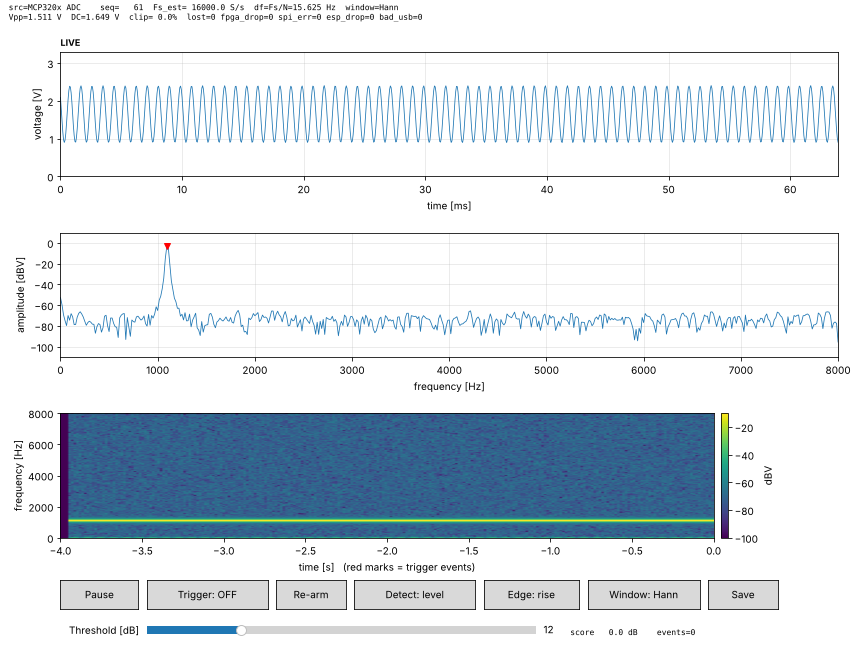
task3/docs/img/host_1100_hann.png
