lolheropro-arch/lab_ii_signal/task3/docs/img/host_1100_rect.png

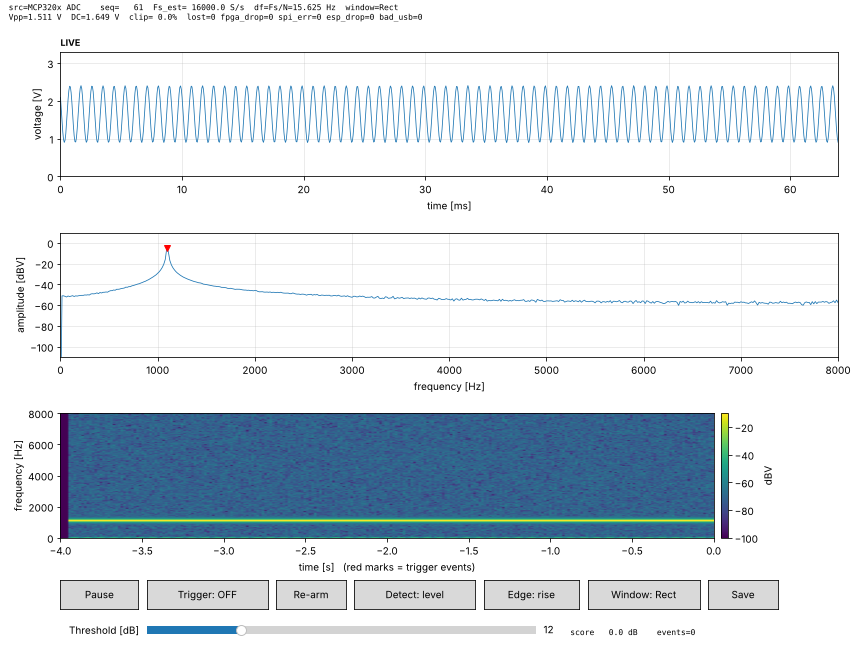
task3/docs/img/host_1100_rect.png
