lolheropro-arch/lab_ii_signal/task3/docs/img/host_silence.png

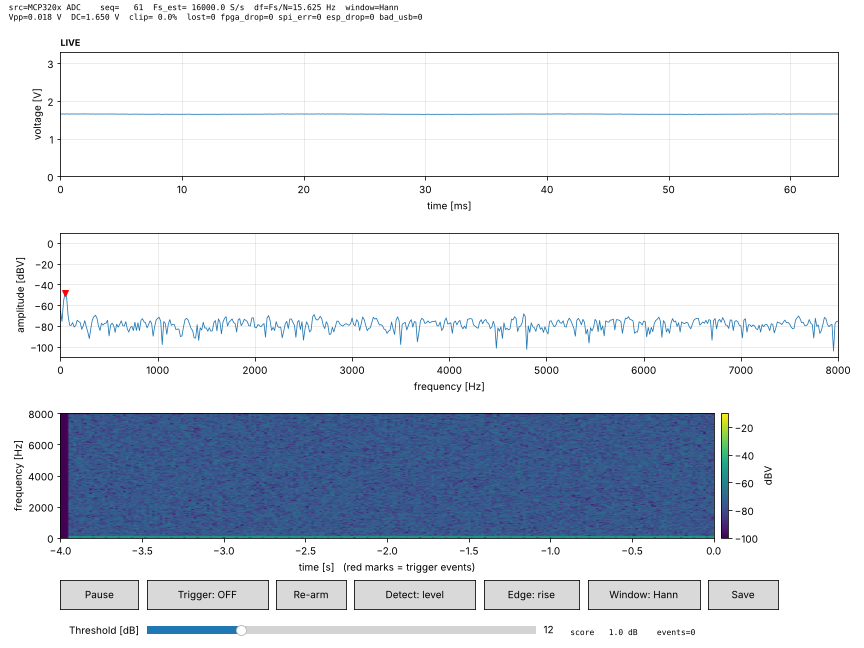
task3/docs/img/host_silence.png
