lolheropro-arch/lab_ii_signal/task3/docs/img/host_square.png

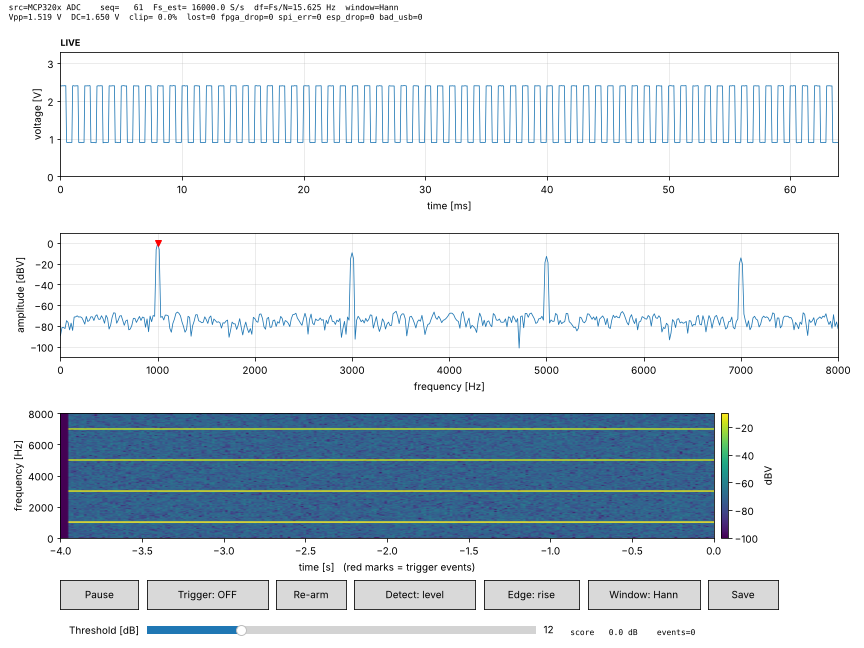
task3/docs/img/host_square.png
