lolheropro-arch/lab_ii_signal/task3/docs/img/scope_drdy.png

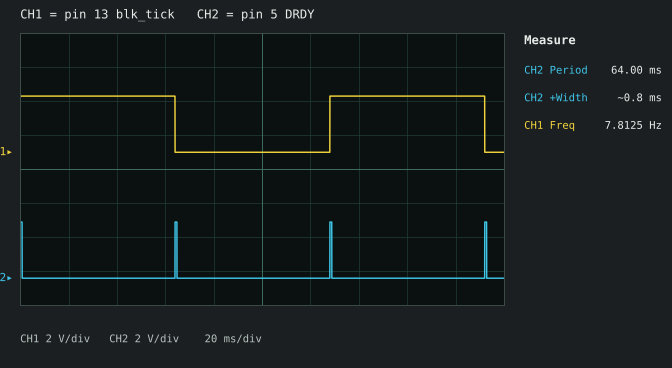
task3/docs/img/scope_drdy.png
