lolheropro-arch/lab_ii_signal/task3/docs/img/scope_fs_tick.png

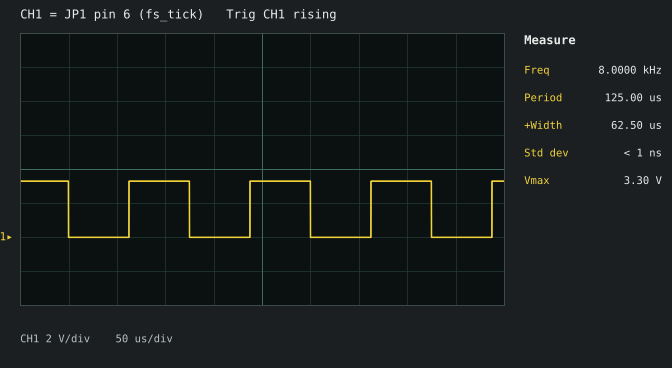
task3/docs/img/scope_fs_tick.png
