lolheropro-arch/lab_ii_signal/task3/docs/img/scope_gen.png

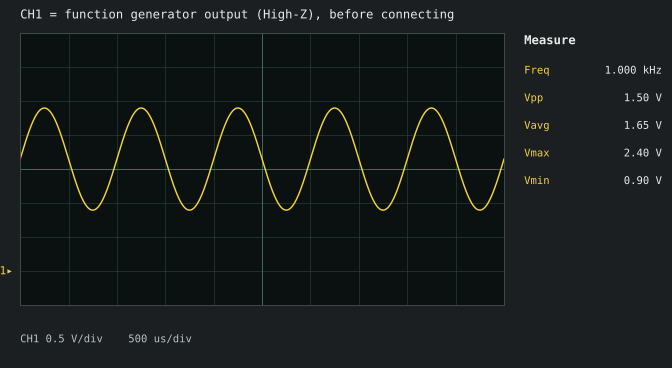
task3/docs/img/scope_gen.png
