lolheropro-arch/lab_ii_signal/task3/results/hardware_setup.jpg

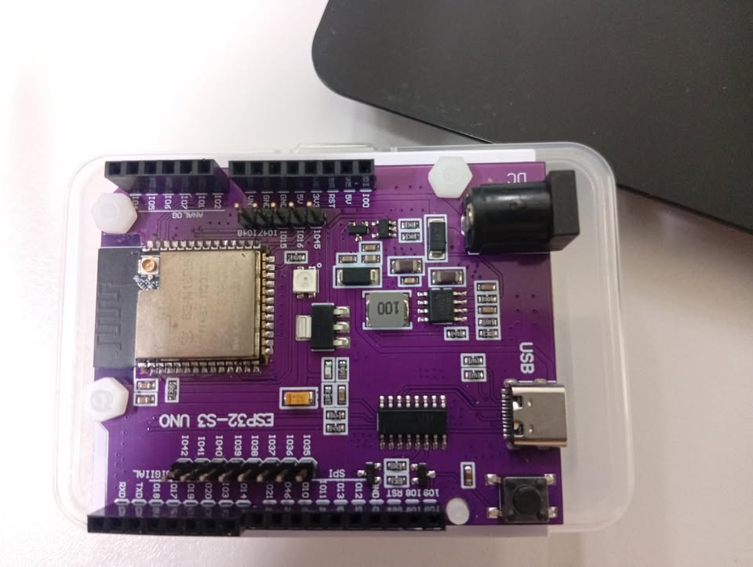
task3/results/hardware_setup.jpg
