lolheropro-arch/lab_ii_signal/task1/results/matlab/clapping1.png

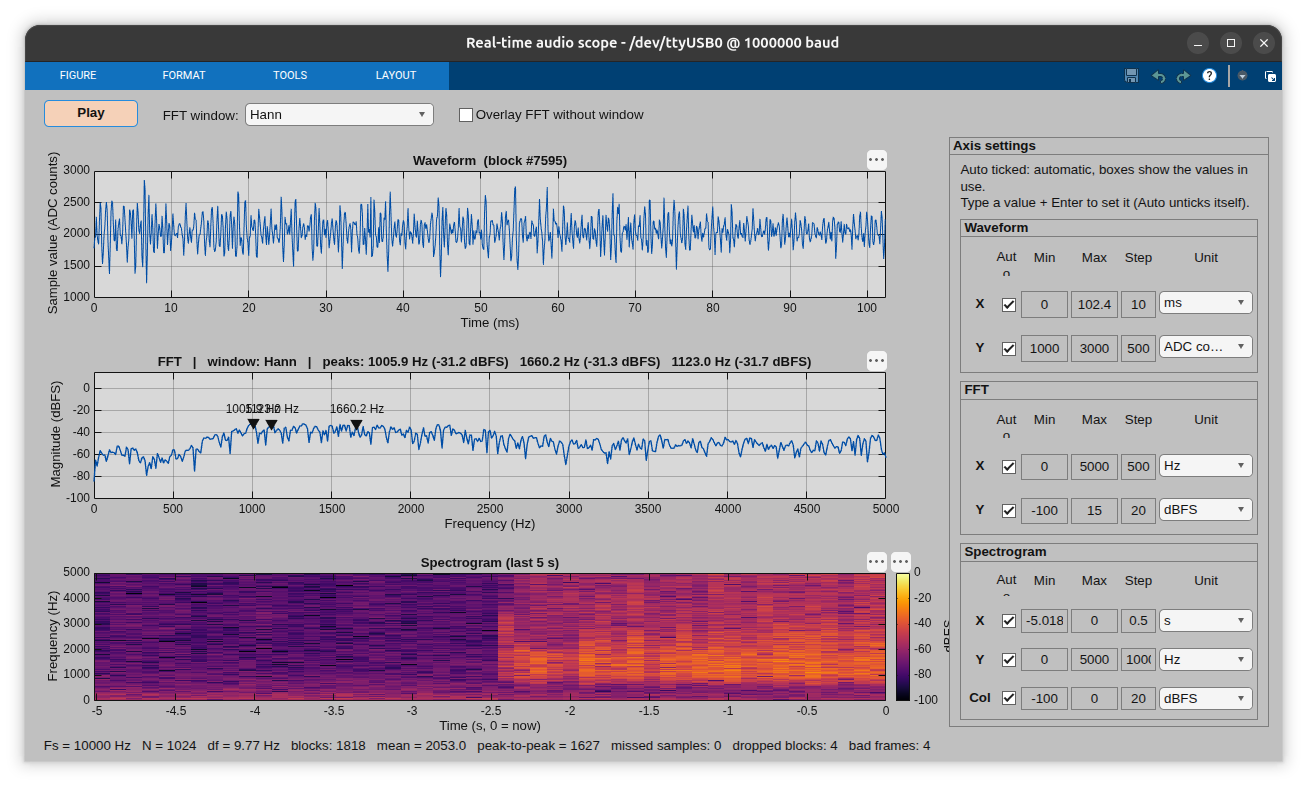
task1/results/matlab/clapping1.png
