lolheropro-arch/lab_ii_signal/task1/results/matlab/clapping.png

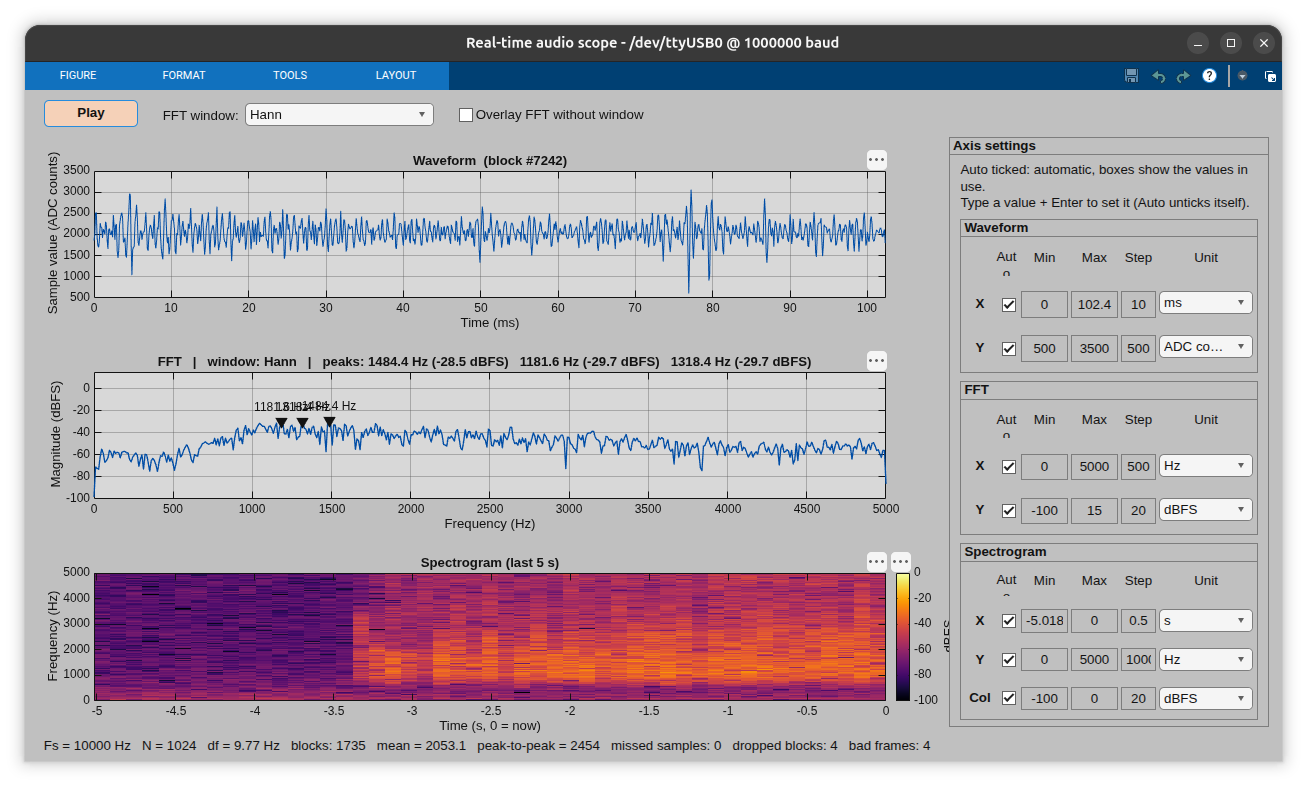
task1/results/matlab/clapping.png
