lolheropro-arch/lab_ii_signal/task1/results/matlab/notes1.png

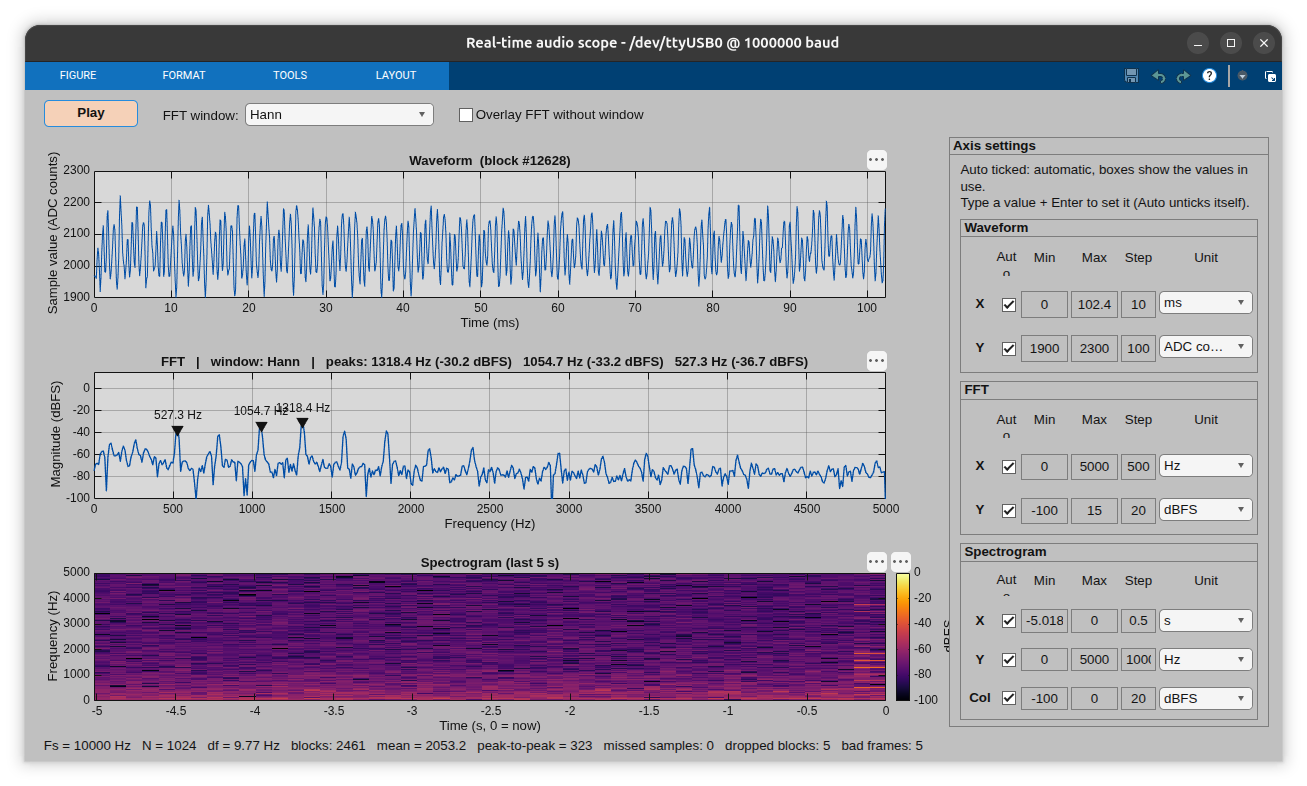
task1/results/matlab/notes1.png
