lolheropro-arch/lab_ii_signal/task1/results/matlab/notes.png

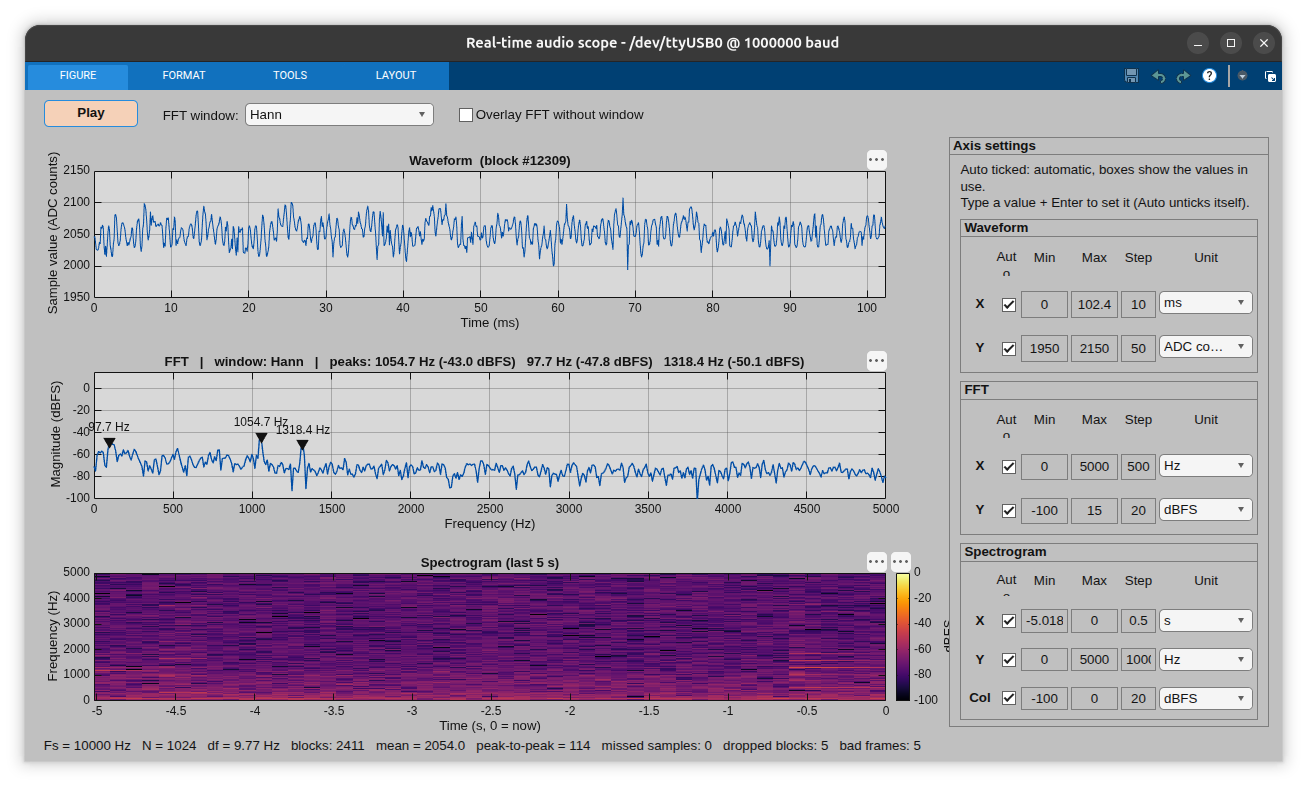
task1/results/matlab/notes.png
