lolheropro-arch/lab_ii_signal/task1/results/matlab/silent1.png

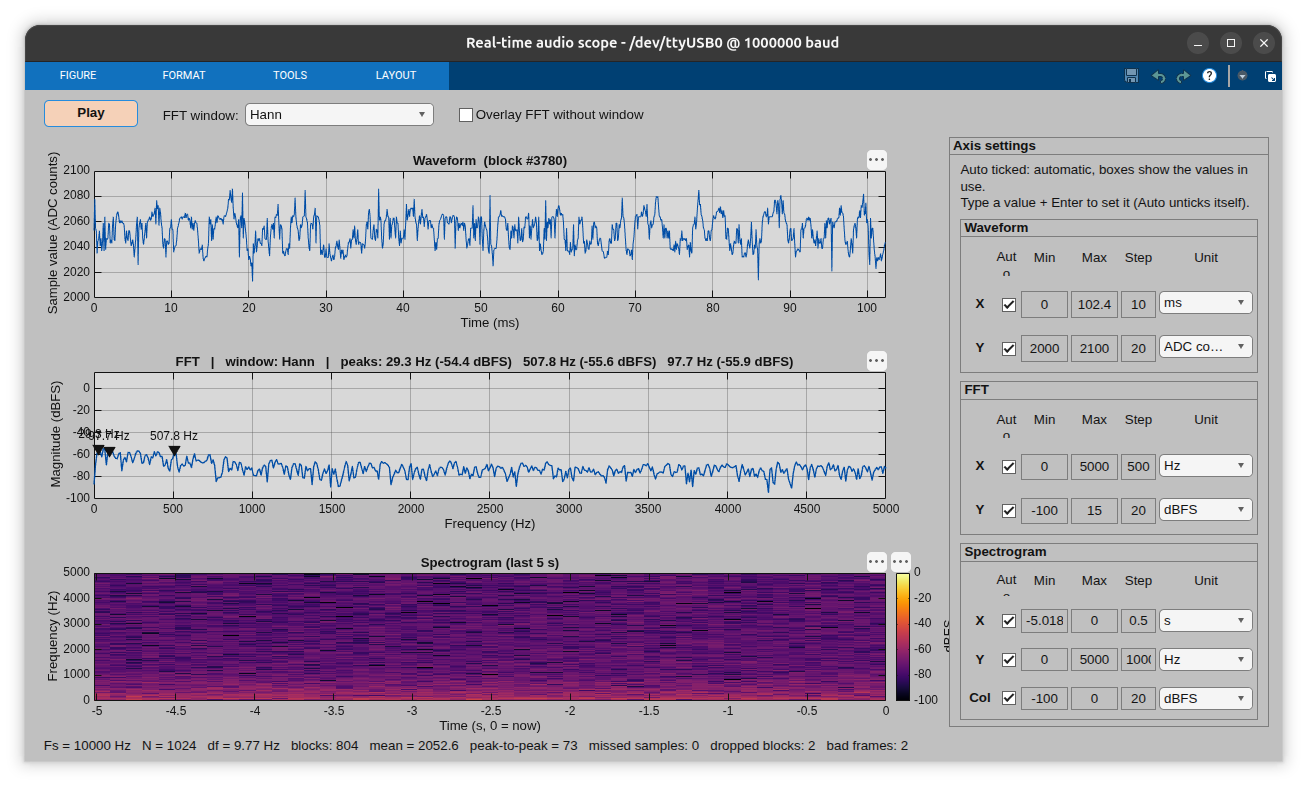
task1/results/matlab/silent1.png
