lolheropro-arch/lab_ii_signal/task1/results/matlab/silent.png

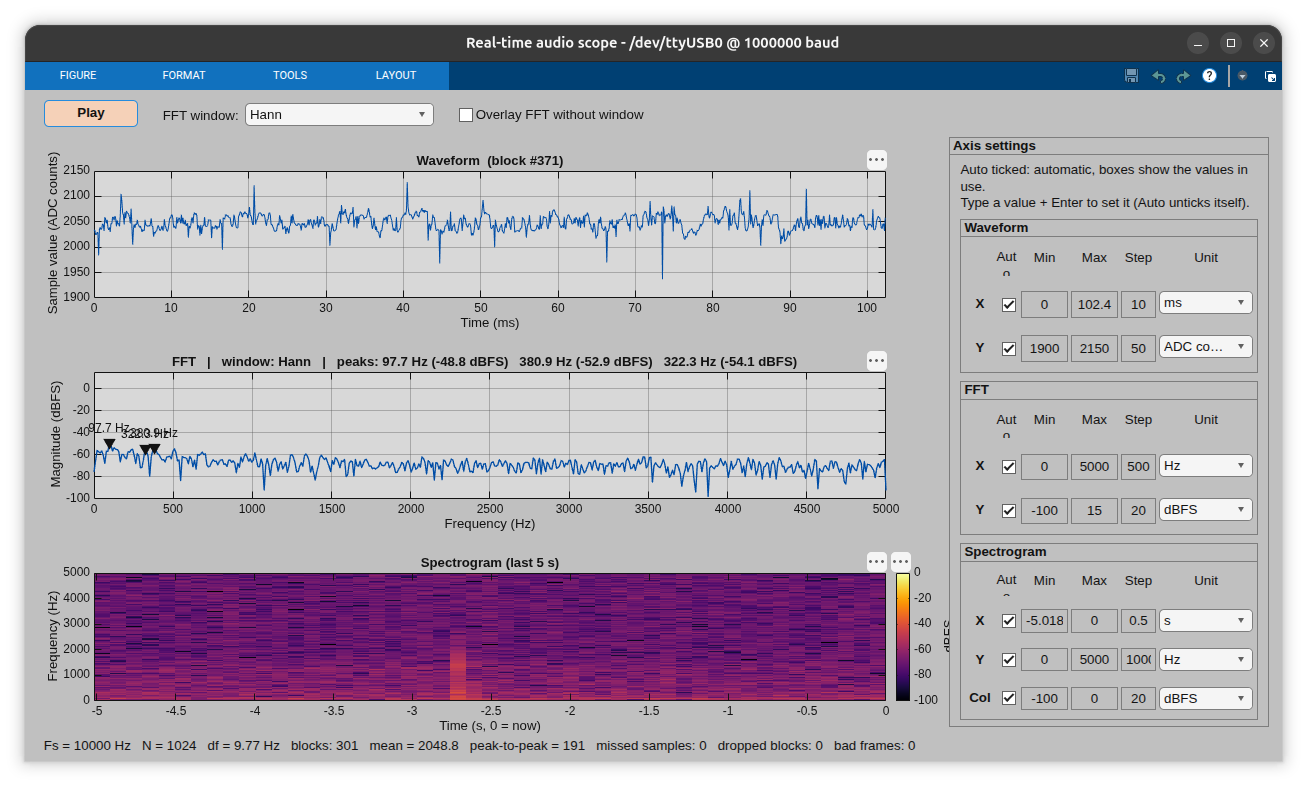
task1/results/matlab/silent.png
