lolheropro-arch/lab_ii_signal/task1/results/matlab/sin1khz2.png

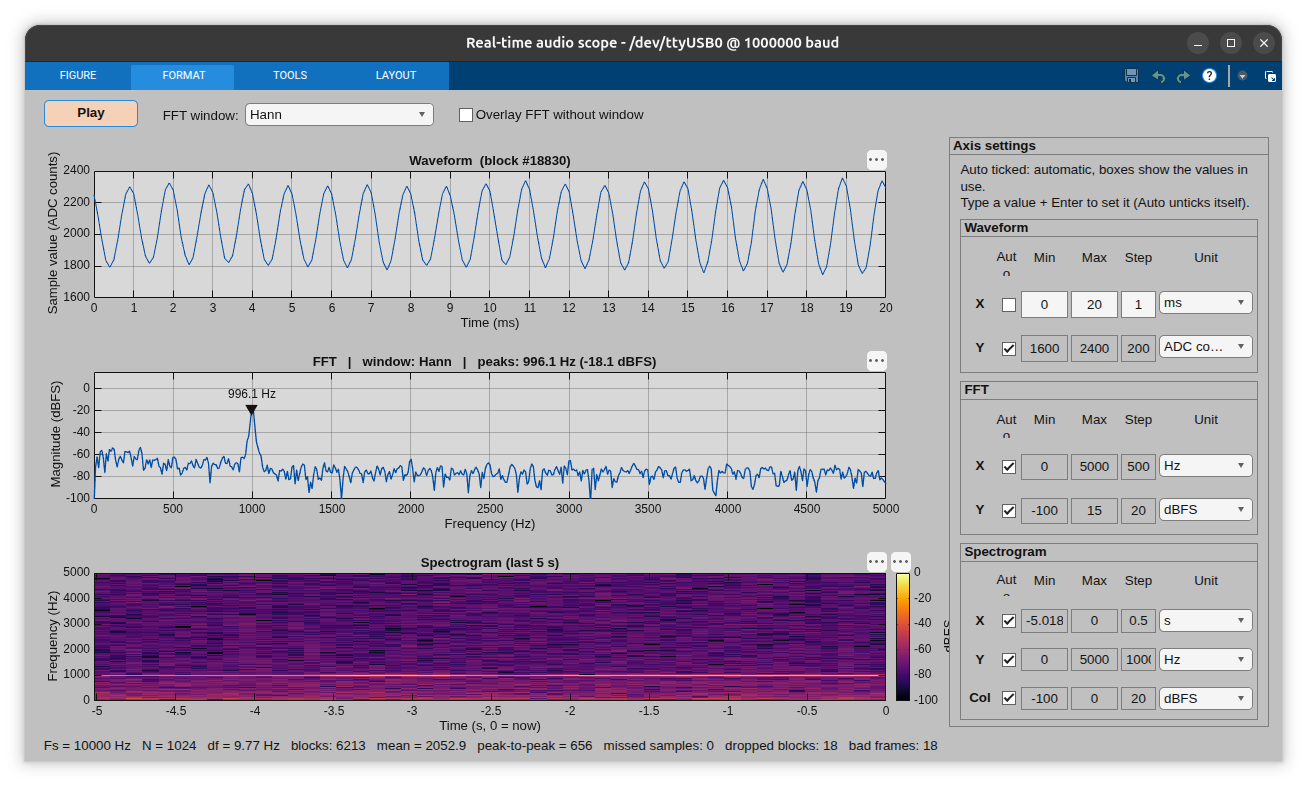
task1/results/matlab/sin1khz2.png
