lolheropro-arch/lab_ii_signal/task1/results/matlab/sqr1khz1.png

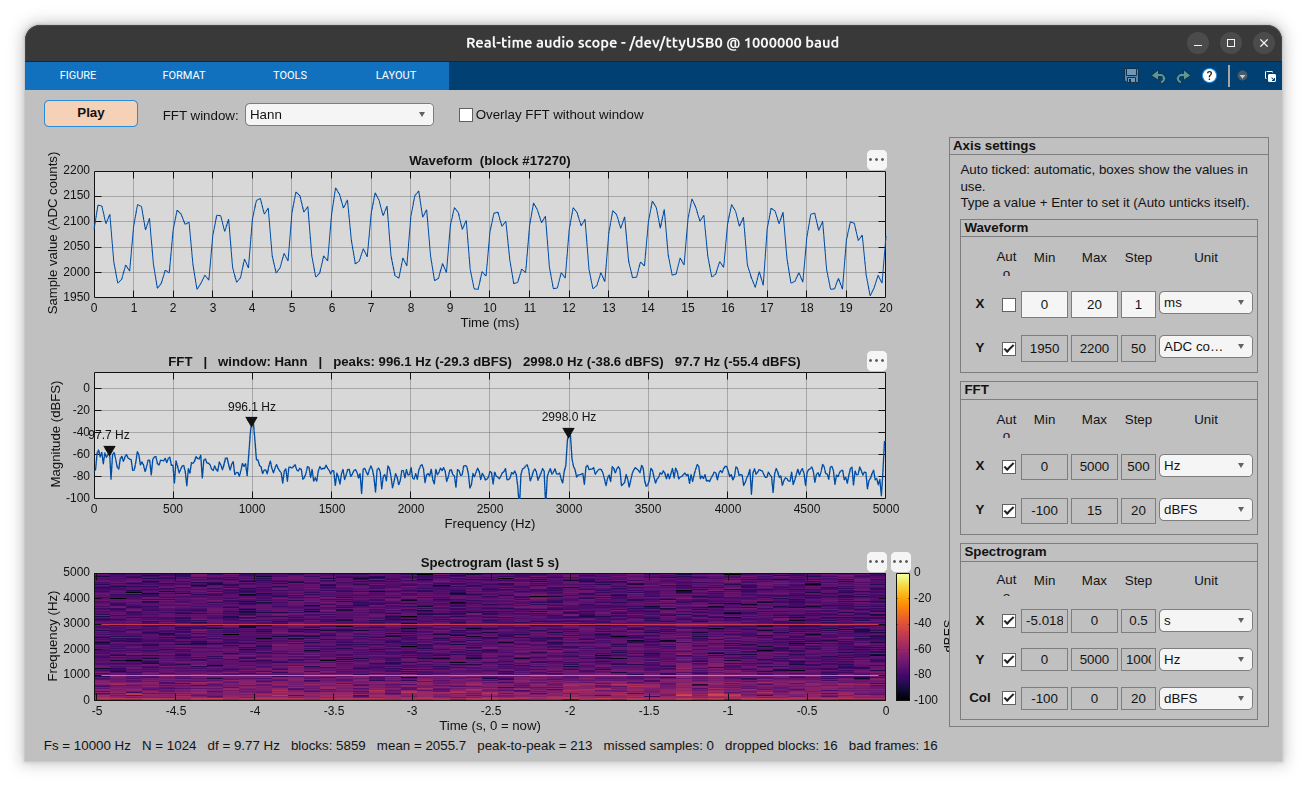
task1/results/matlab/sqr1khz1.png
