lolheropro-arch/lab_ii_signal/task1/results/matlab/talk1.png

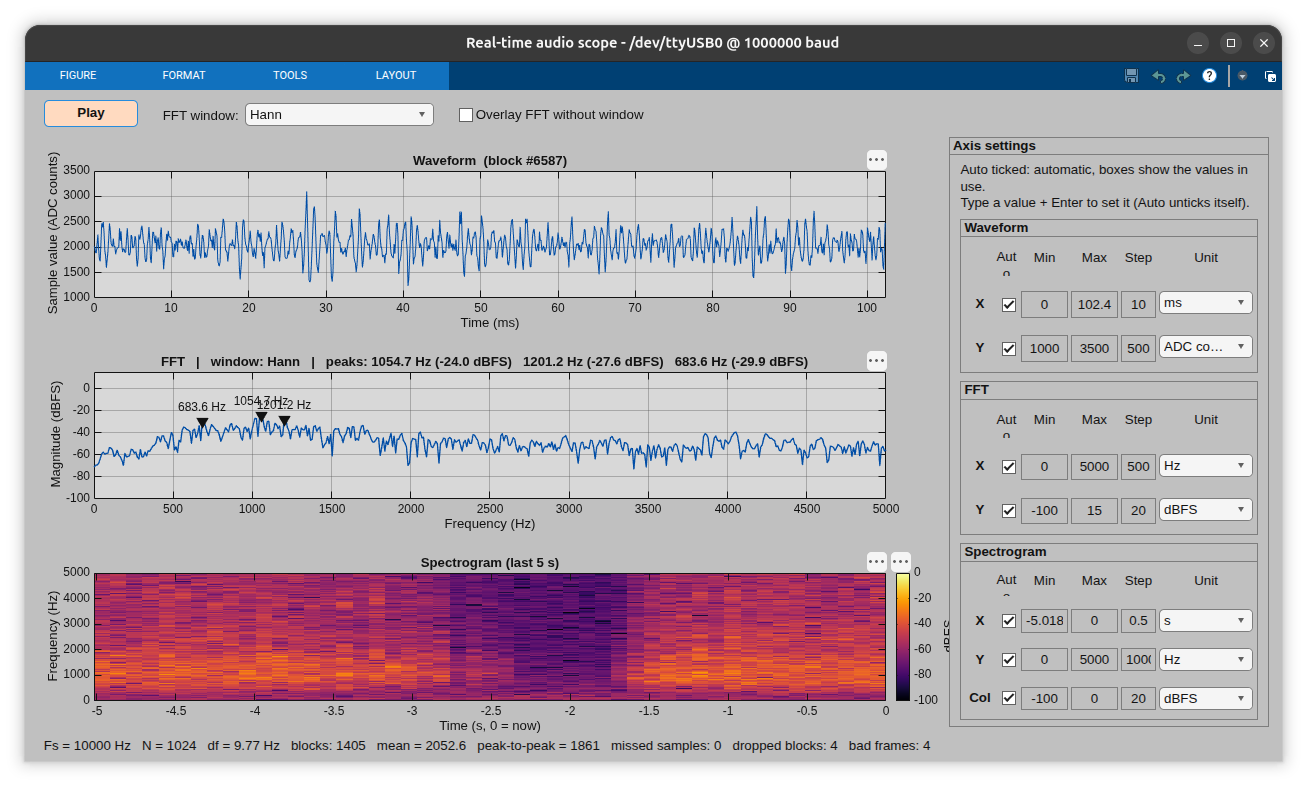
task1/results/matlab/talk1.png
