lolheropro-arch/lab_ii_signal/task1/results/matlab/whistle1.png

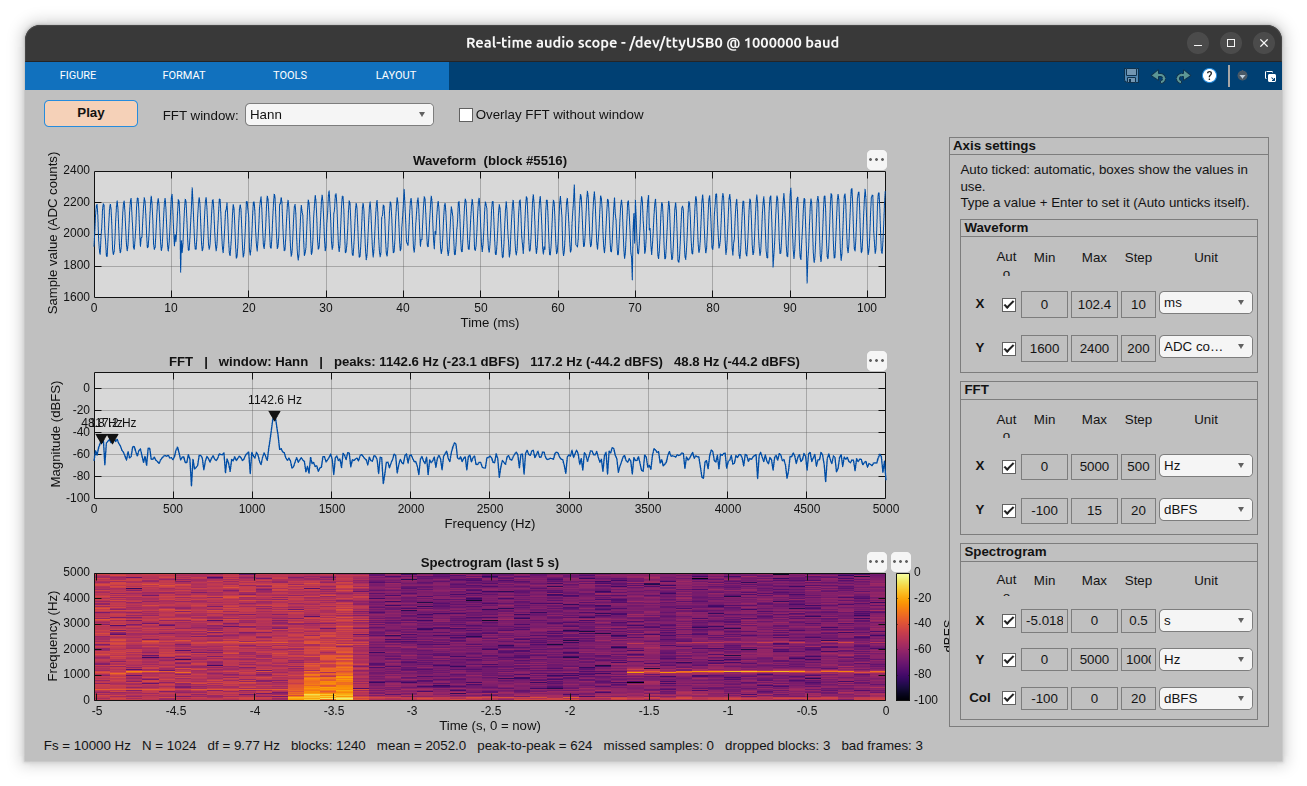
task1/results/matlab/whistle1.png
