lolheropro-arch/lab_ii_signal/task1/results/matlab/whistle.png

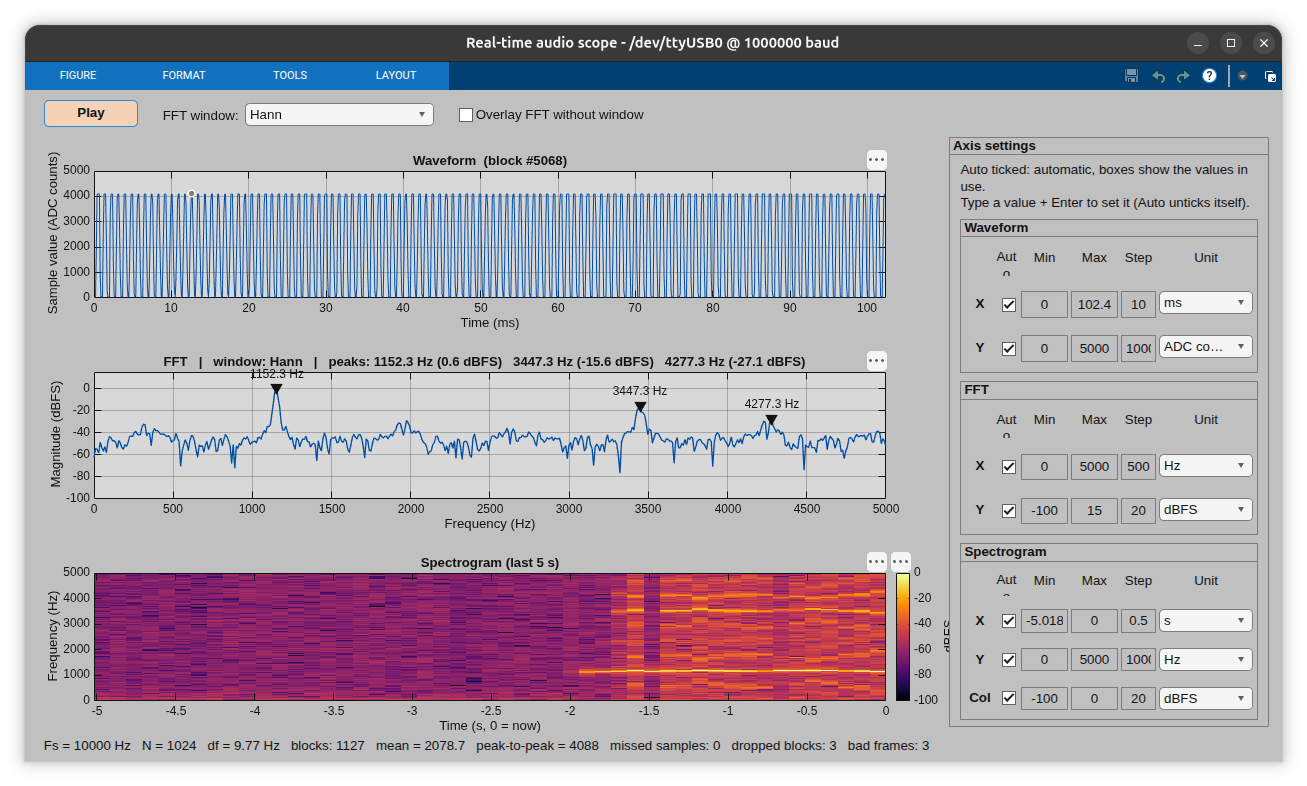
task1/results/matlab/whistle.png
