lolheropro-arch/lab_ii_signal/task1/results/oscilloscope/clp0.png

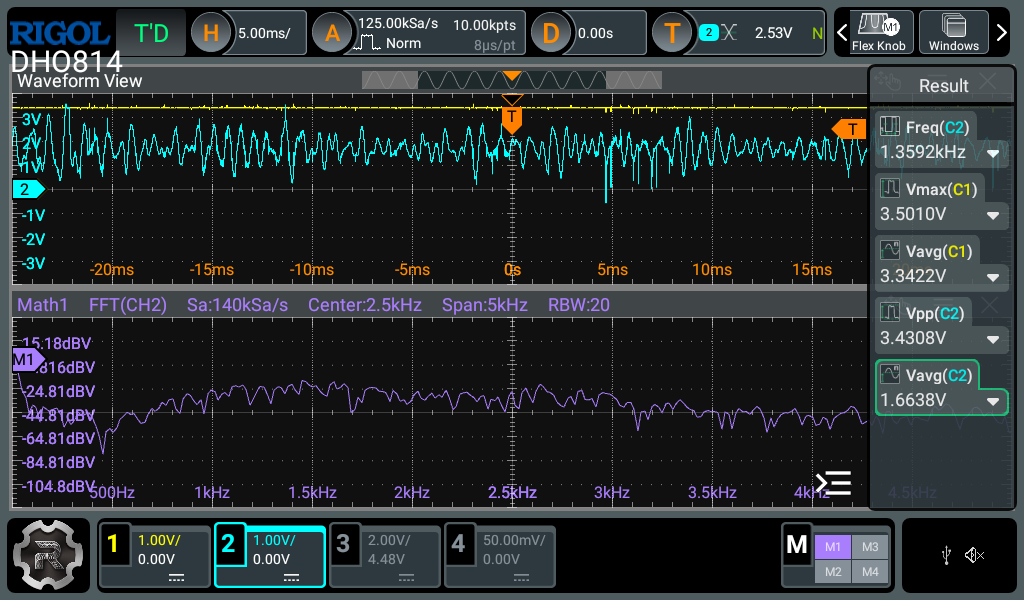
task1/results/oscilloscope/clp0.png
