lolheropro-arch/lab_ii_signal/task1/results/oscilloscope/do0(thenotes).png

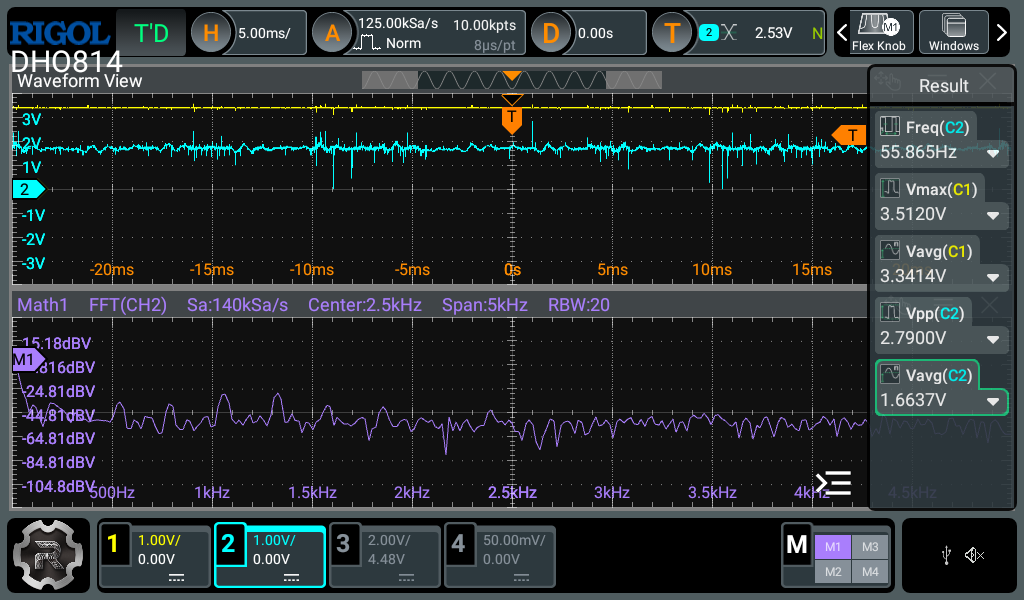
task1/results/oscilloscope/do0(thenotes).png
