lolheropro-arch/lab_ii_signal/task1/results/oscilloscope/silent0.png

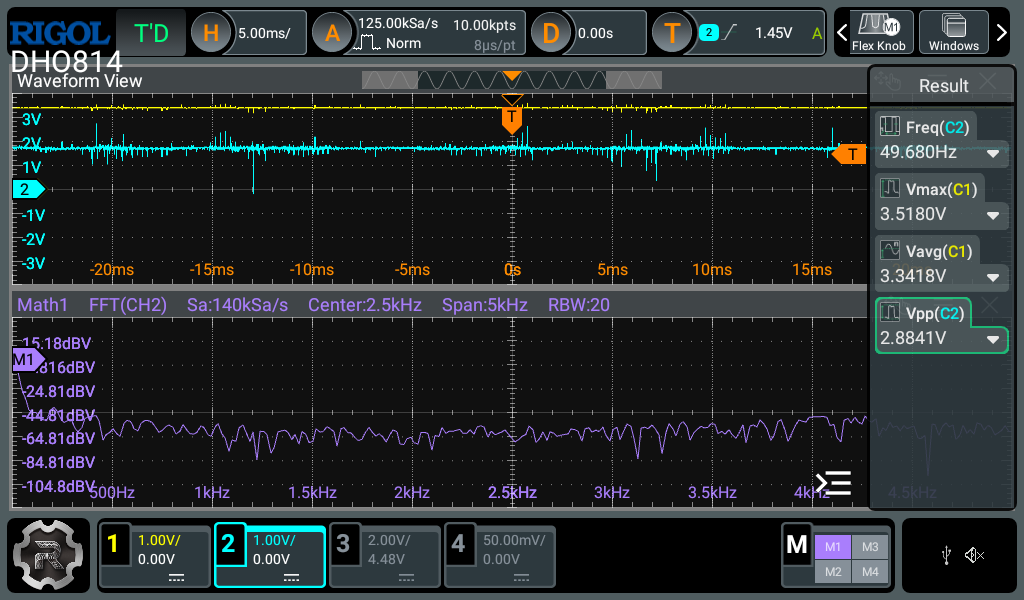
task1/results/oscilloscope/silent0.png
