lolheropro-arch/lab_ii_signal/task1/results/oscilloscope/sin1khz2.png

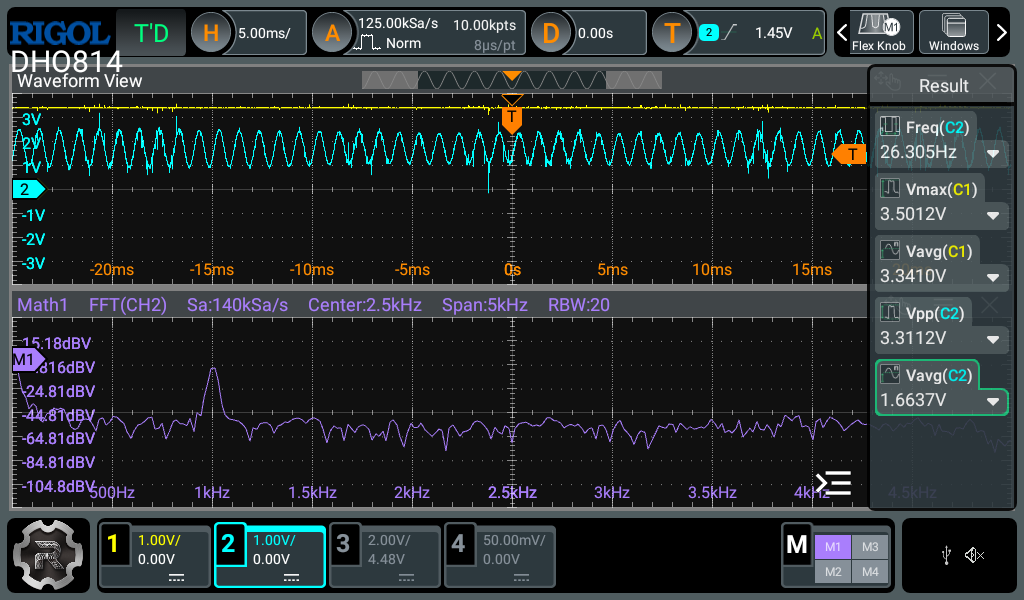
task1/results/oscilloscope/sin1khz2.png
