lolheropro-arch/lab_ii_signal/task1/results/window_vs_no_window/notes.png

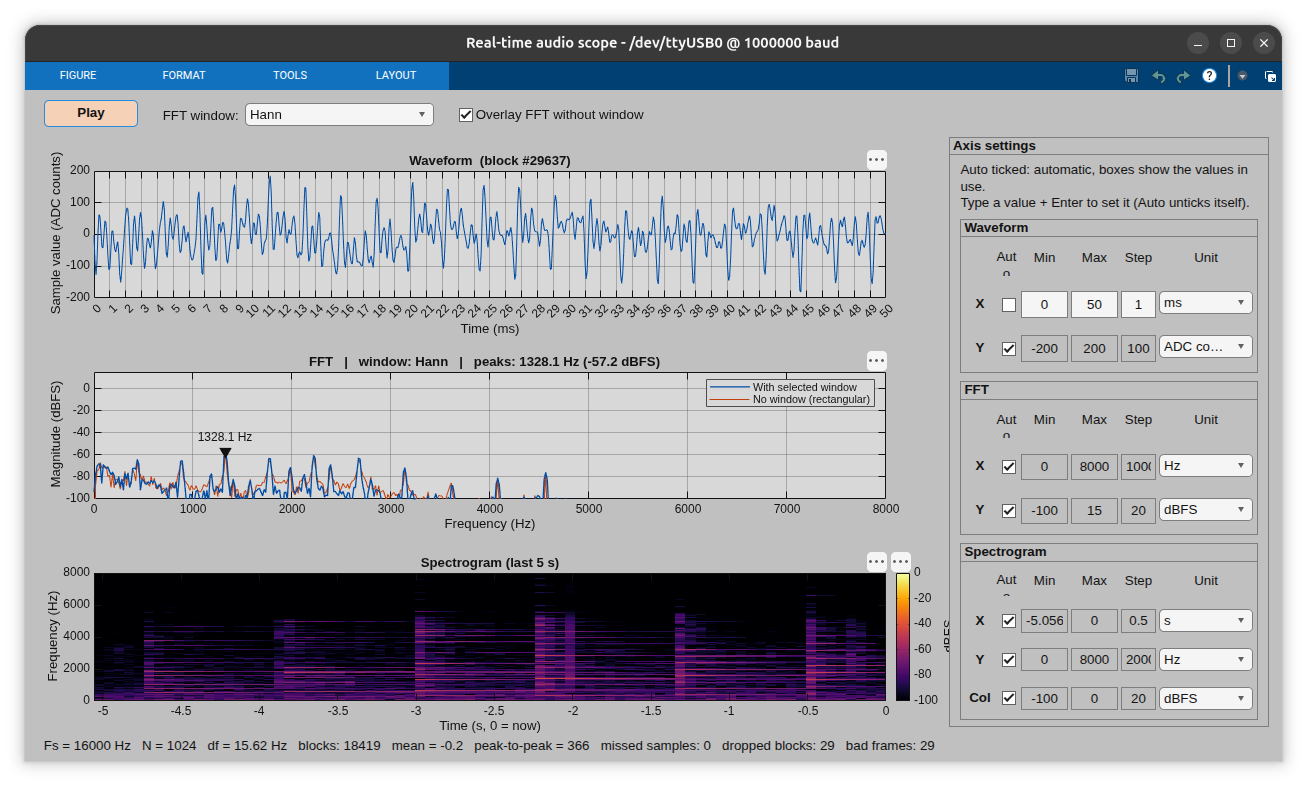
task1/results/window_vs_no_window/notes.png
