lolheropro-arch/lab_ii_signal/task2/results/f_1_task2_whisle_fs=16k.png

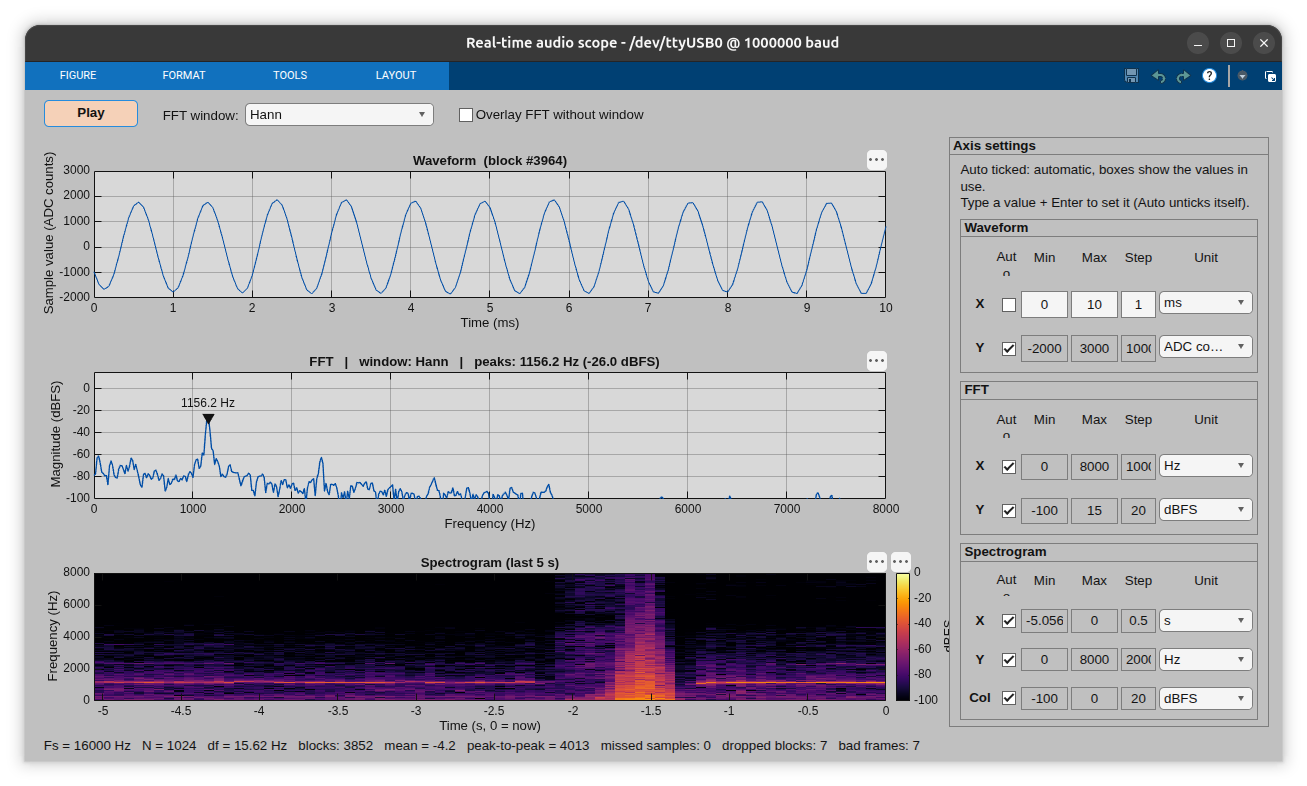
task2/results/f_1_task2_whisle_fs=16k.png
