lolheropro-arch/lab_ii_signal/task2/results/plots/1.silent.png

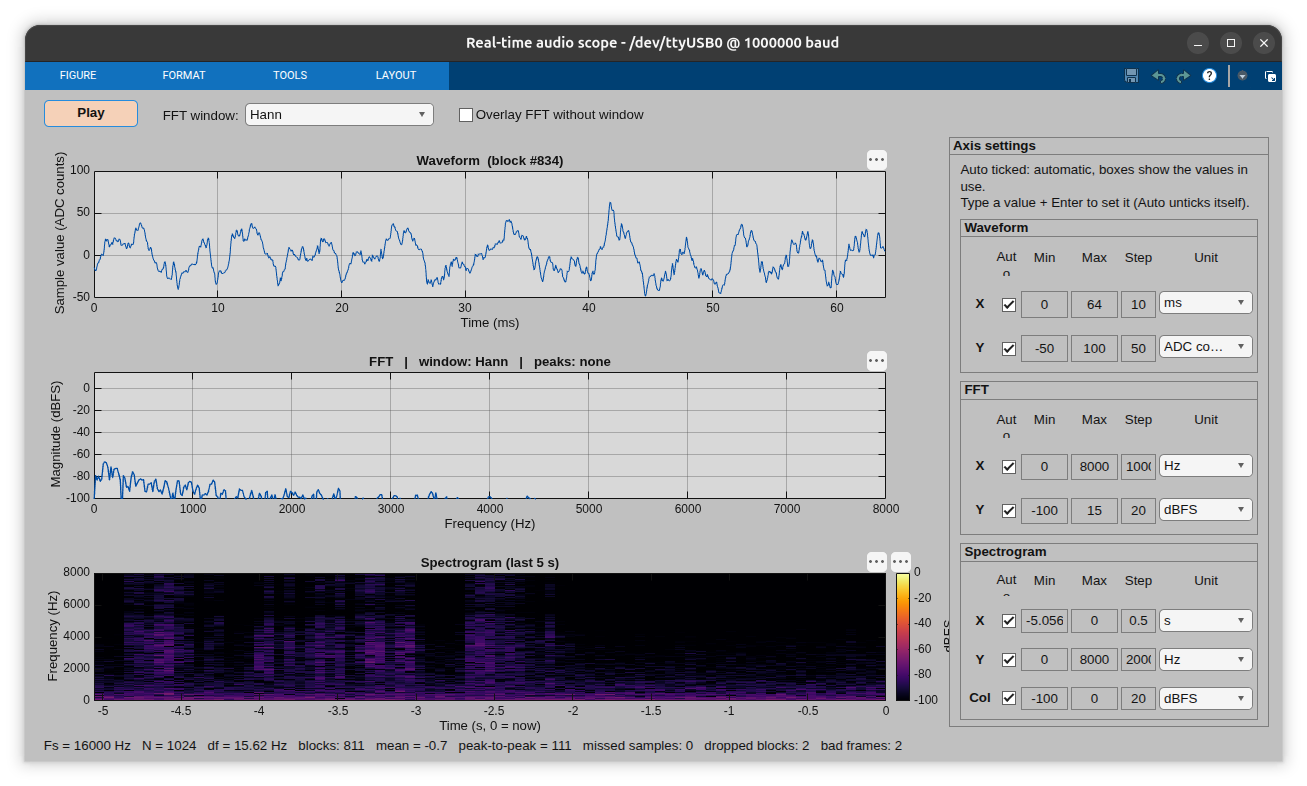
task2/results/plots/1.silent.png
