lolheropro-arch/lab_ii_signal/task2/results/plots/3.talk.png

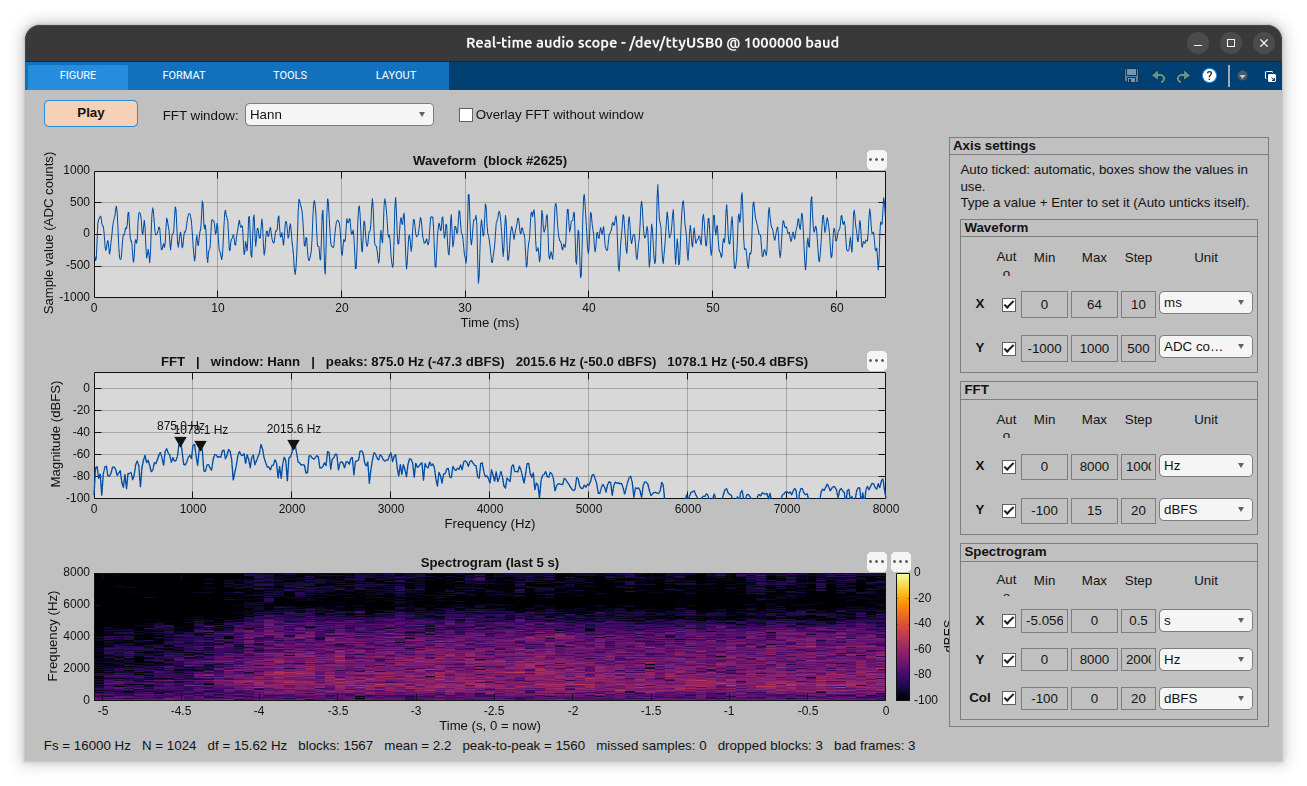
task2/results/plots/3.talk.png
