lolheropro-arch/lab_ii_signal/task2/results/plots/4.talk.png

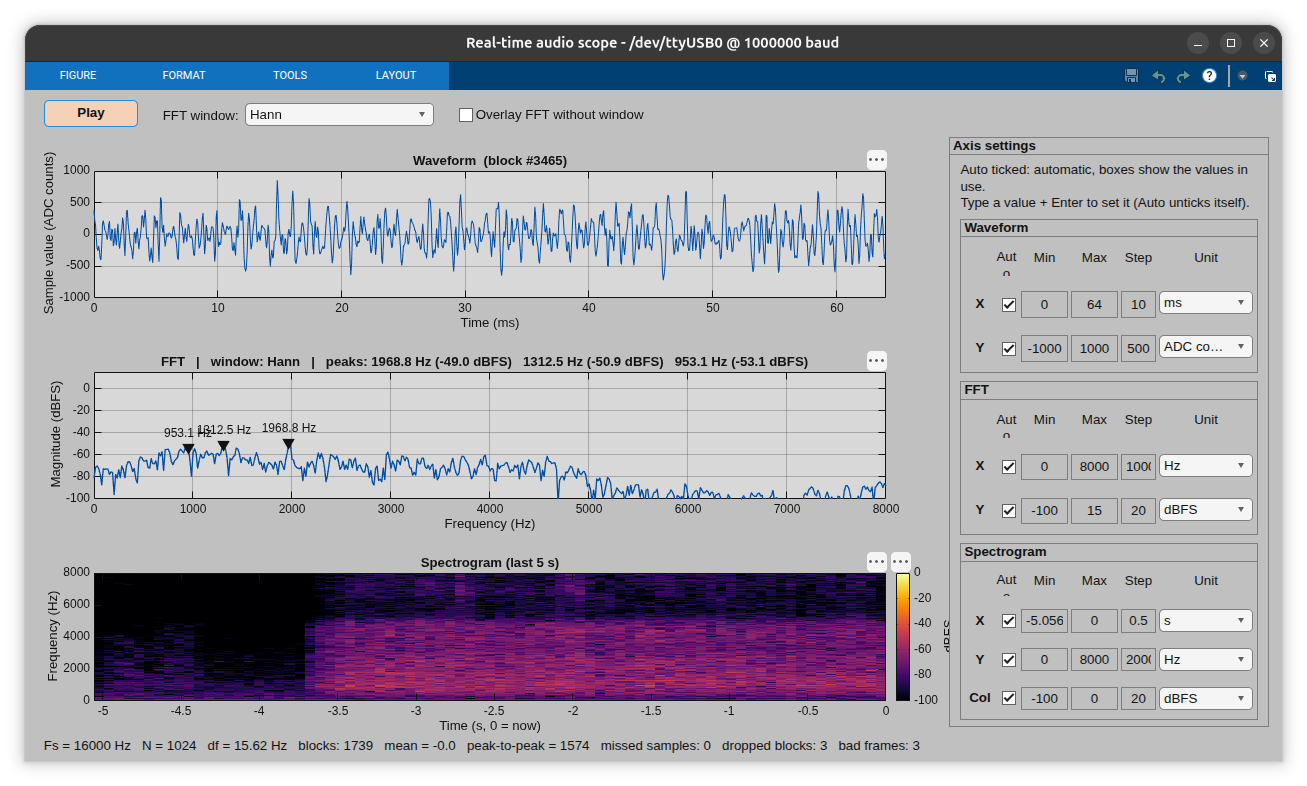
task2/results/plots/4.talk.png
