lolheropro-arch/lab_ii_signal/task2/results/plots/5.clapping.png

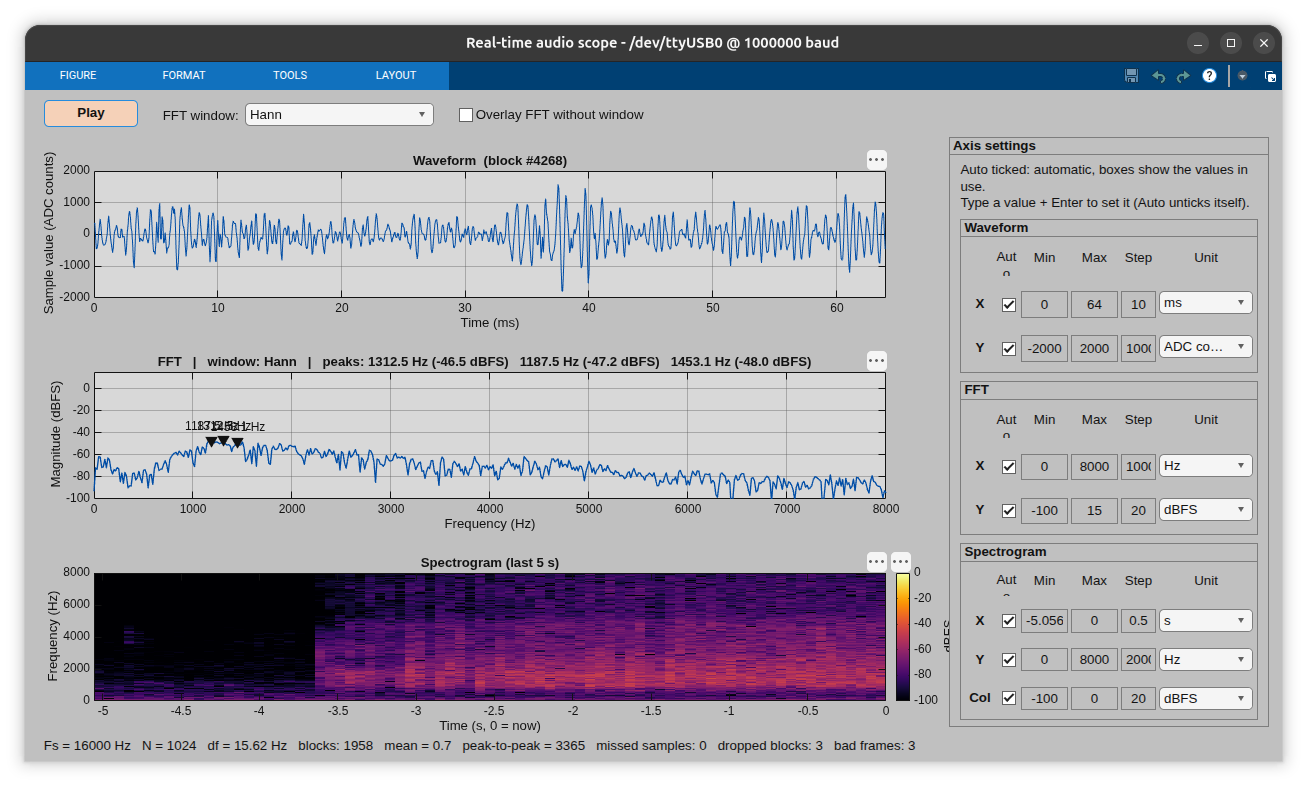
task2/results/plots/5.clapping.png
