lolheropro-arch/lab_ii_signal/task2/results/plots/7.notes.png

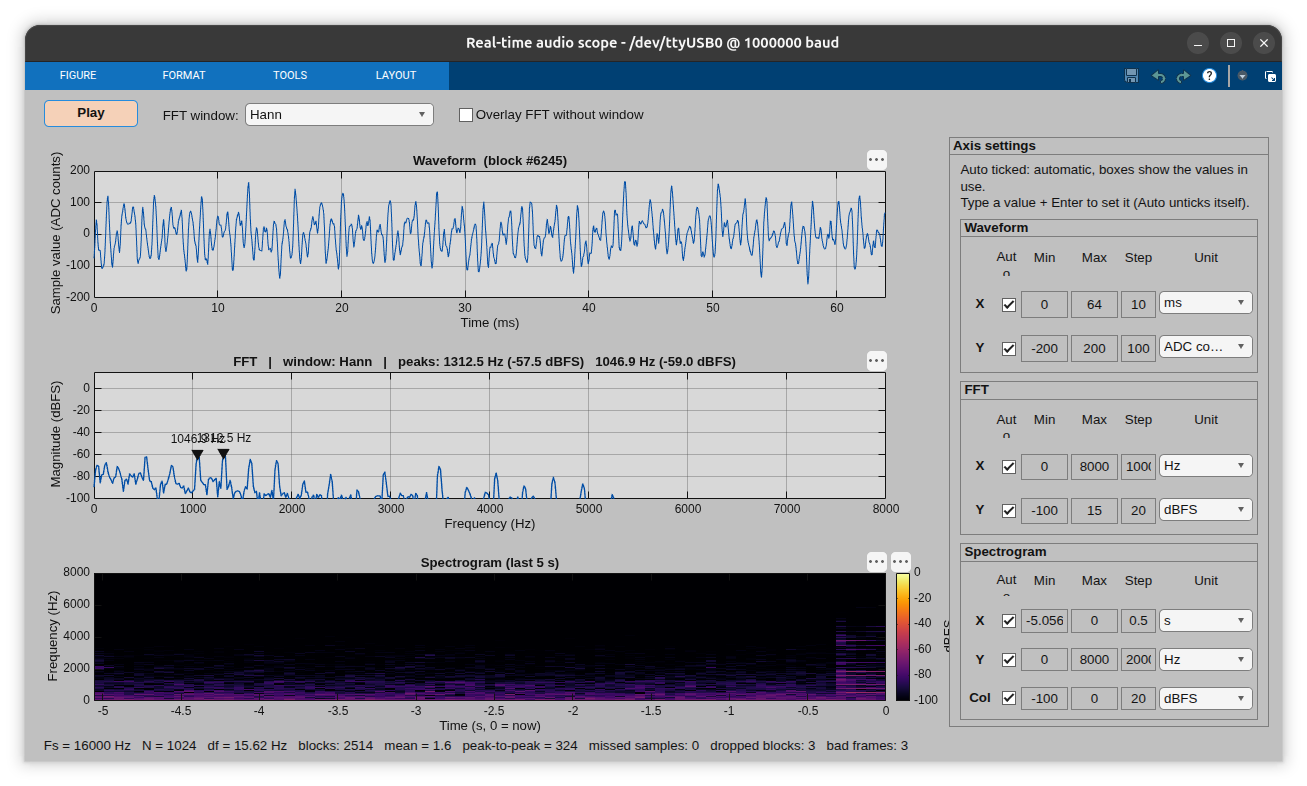
task2/results/plots/7.notes.png
