lolheropro-arch/lab_ii_signal/task2/results/plots/9.sin1khz.png

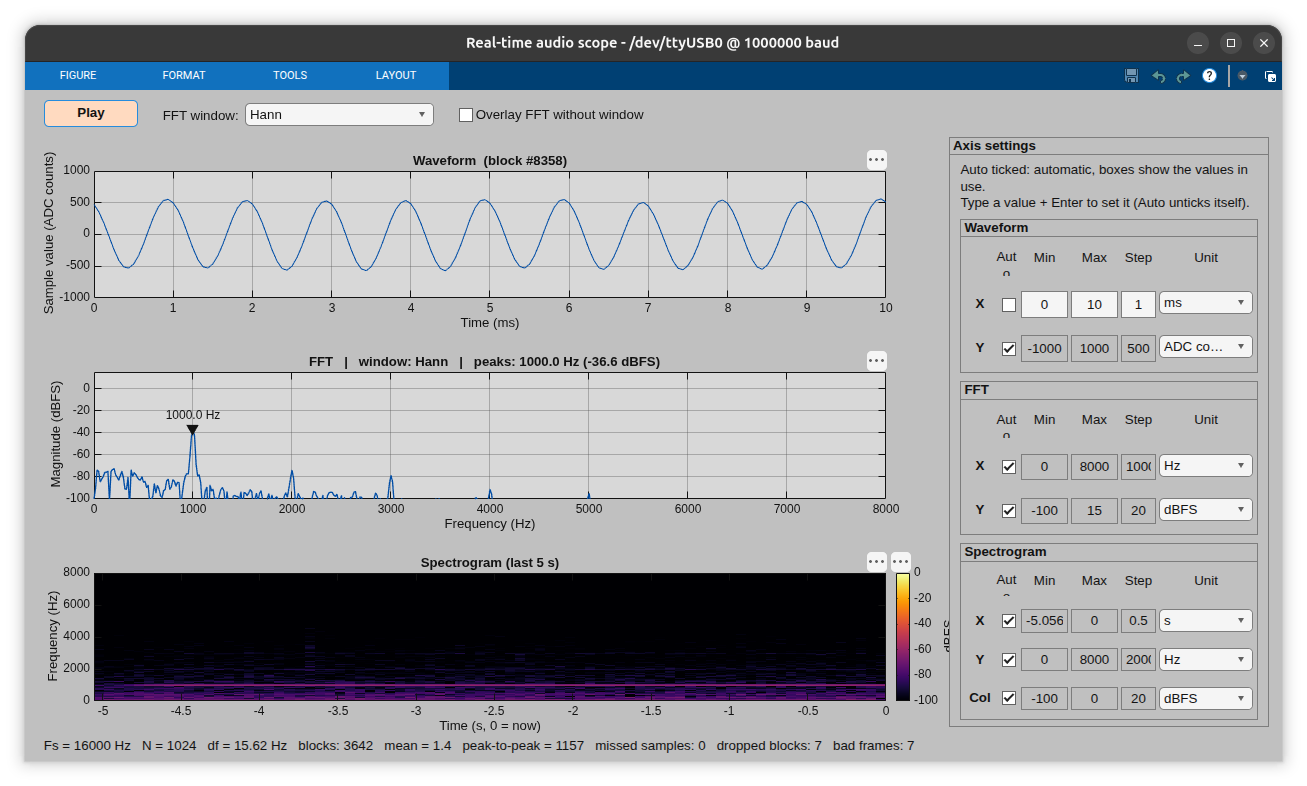
task2/results/plots/9.sin1khz.png
