lolheropro-arch/lab_ii_signal/task2/results/plots/12.whistle.png

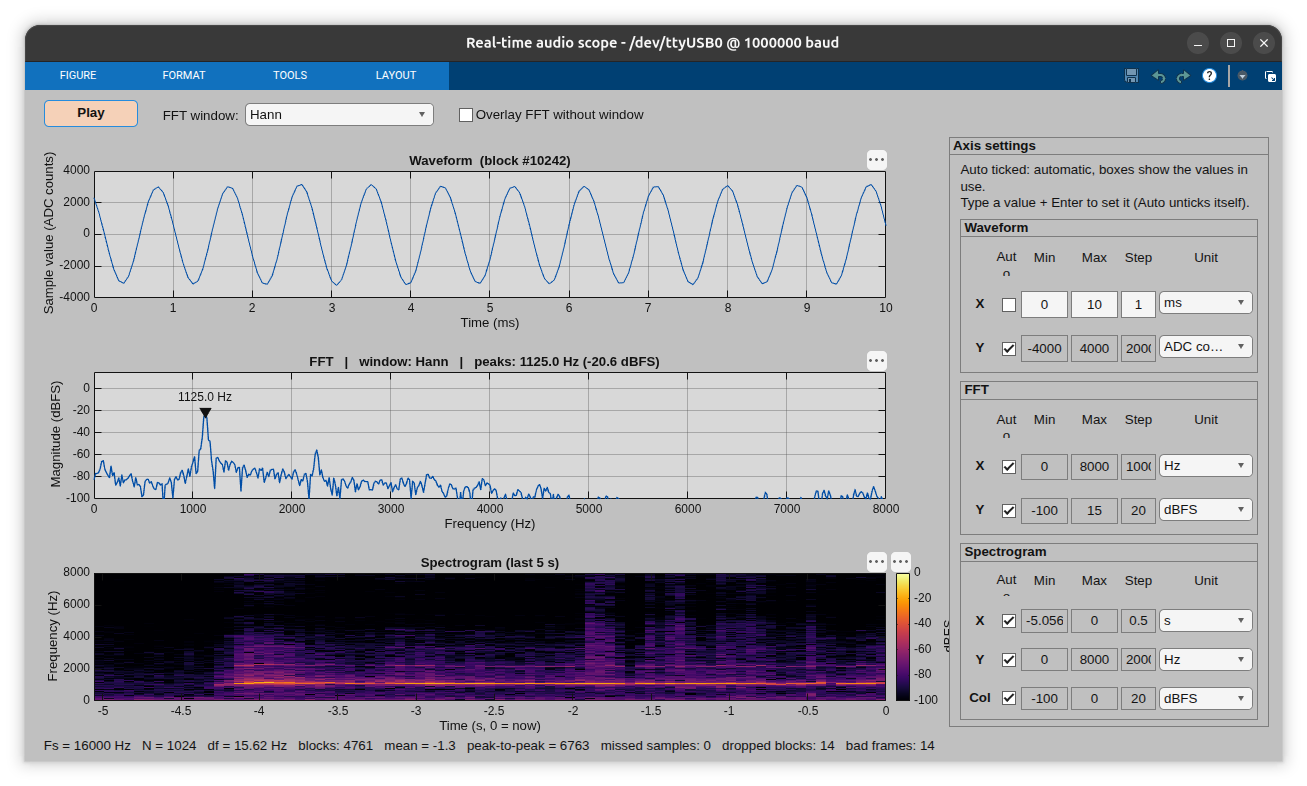
task2/results/plots/12.whistle.png
