lolheropro-arch/lab_ii_signal/task2/results/plots/13.sqr1khz.png

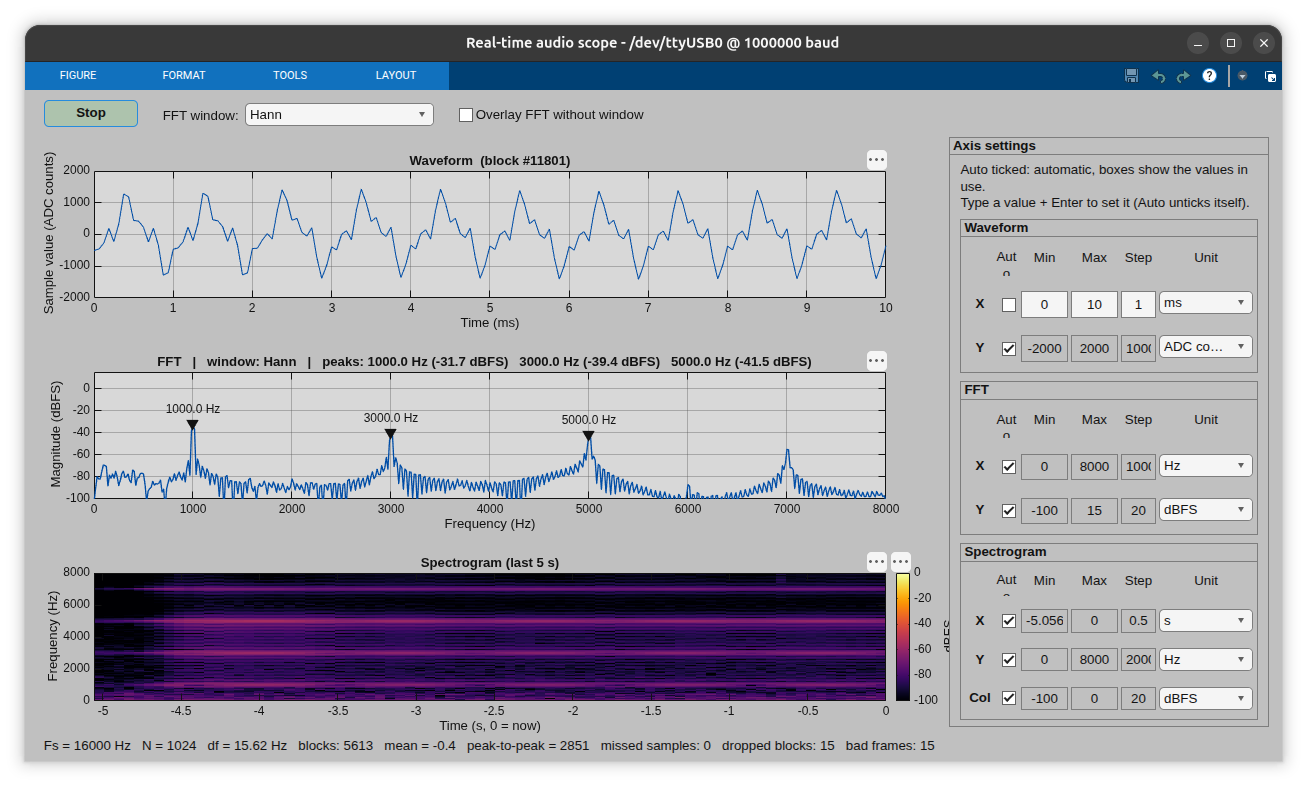
task2/results/plots/13.sqr1khz.png
