lolheropro-arch/lab_ii_signal/task2/results/plots/notsilent.png

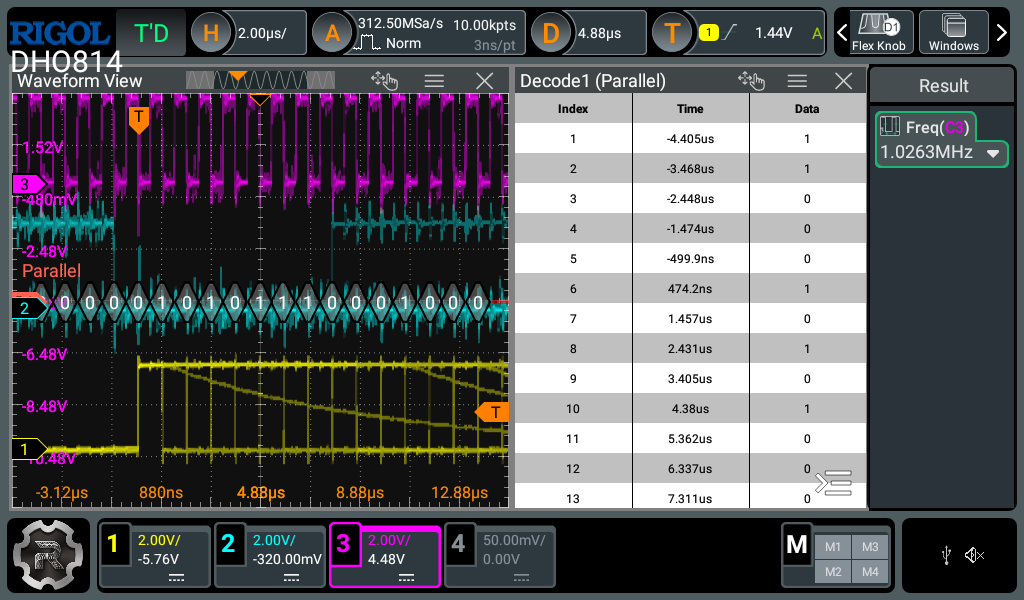
task2/results/plots/notsilent.png
