lolheropro-arch/lab_ii_signal/task2/results/plots/RigolDS2.png

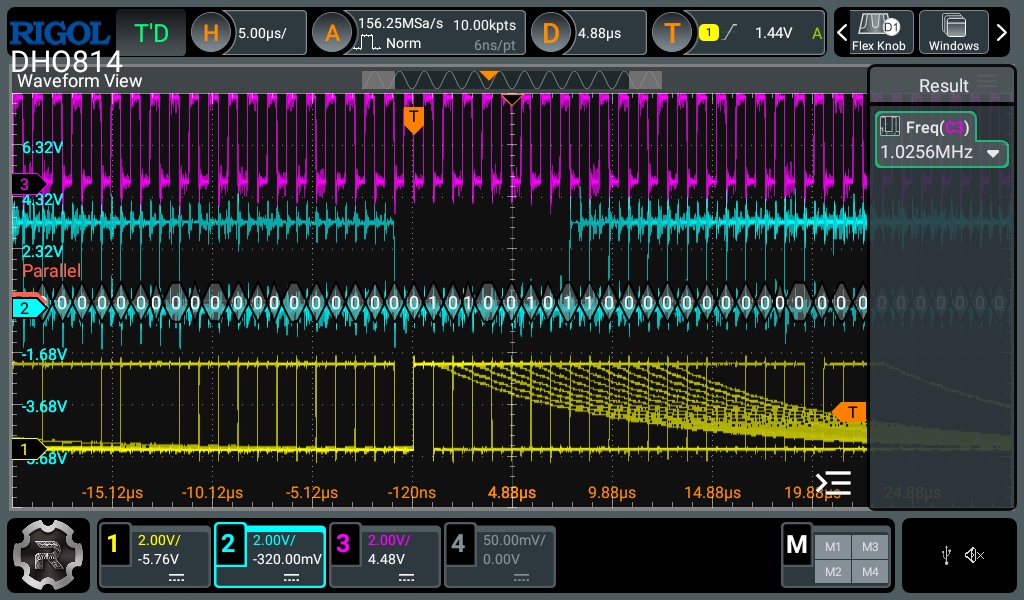
task2/results/plots/RigolDS2.png
