lolheropro-arch/lab_ii_signal/task1/results/fix_comparison/silencefix1.png

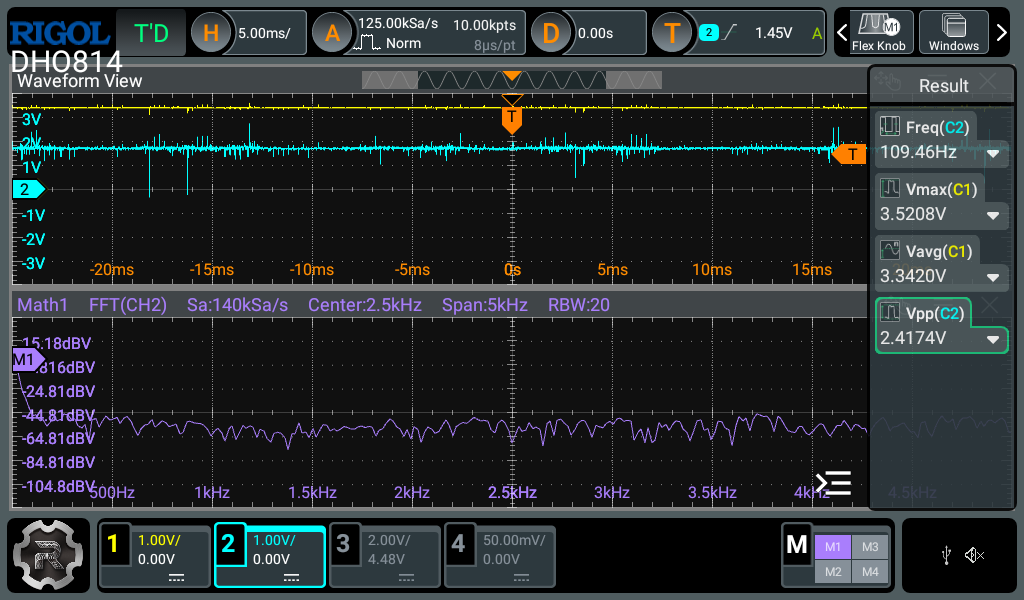
task1/results/fix_comparison/silencefix1.png
