lolheropro-arch/lab_ii_signal/task1/results/fix_comparison/silent0.png

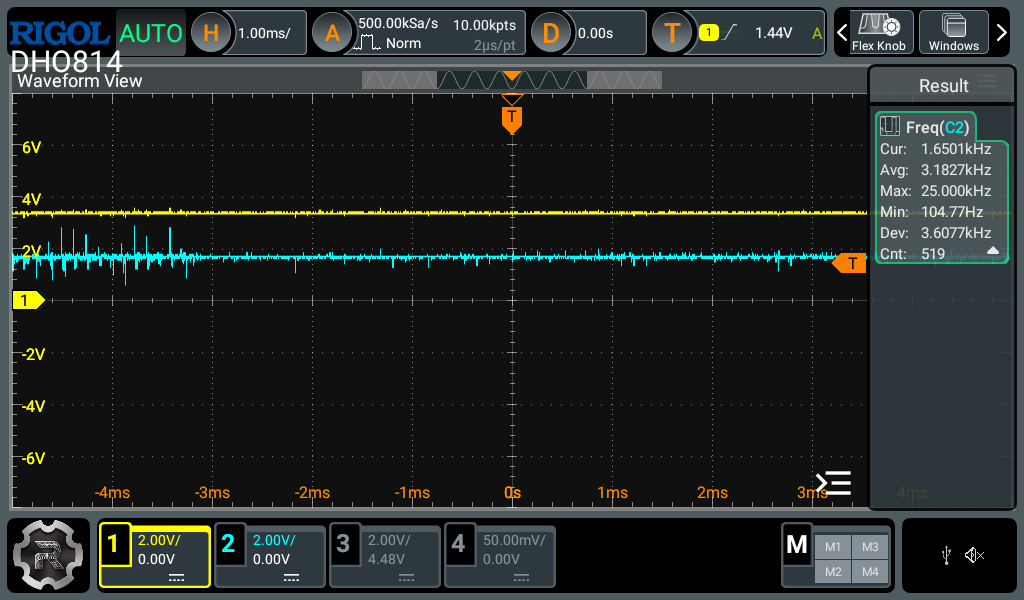
task1/results/fix_comparison/silent0.png
