lolheropro-arch/lab_ii_signal/task1/results/fix_comparison/talk0.png

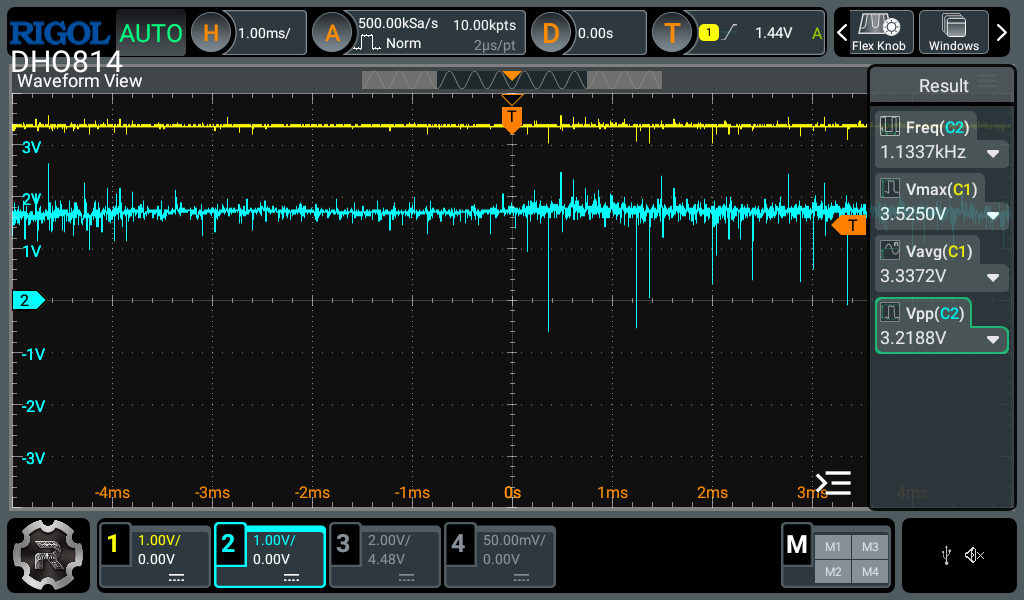
task1/results/fix_comparison/talk0.png
