lolheropro-arch/lab_ii_signal/mini_project/config.py

"""
config.py — ค่าตั้งทั้งหมดของโปรแกรมอยู่ที่ไฟล์นี้ไฟล์เดียว
=====================================================================
แก้ค่าที่นี่แล้วรันโปรแกรมใหม่ ไม่ต้องไปแก้ในไฟล์อื่น
"""
import sys
from pathlib import Path

# ---------------------------------------------------------------------
# 1) ตำแหน่งไฟล์
# ---------------------------------------------------------------------
BASE_DIR = Path(__file__).resolve().parent
SONGS_DIR = BASE_DIR / "songs"            # โฟลเดอร์ใส่ไฟล์เพลง (mp3/wav/...)
DB_PATH = BASE_DIR / "fingerprints.db"    # ฐานข้อมูล hash (สร้างให้อัตโนมัติ)
RESULTS_DIR = BASE_DIR / "results"        # ผลการทดลองจาก experiment.py
AUDIO_EXTENSIONS = (".mp3", ".wav", ".flac", ".ogg", ".m4a")

# ---------------------------------------------------------------------
# 2) การรับเสียงจาก ESP32 ผ่าน USB-Serial
#    ต้องตั้งให้ตรงกับ Arduino sketch ที่ส่งข้อมูลมา
# ---------------------------------------------------------------------
# Windows ใช้ "COM3", "COM4", ...   Linux ใช้ "/dev/ttyUSB0" หรือ "/dev/ttyACM0"
# (ใน GUI เลือกพอร์ตใหม่ได้ ค่านี้เป็นแค่ค่าเริ่มต้น)
SERIAL_PORT = "COM3" if sys.platform.startswith("win") else "/dev/ttyUSB0"
BAUD_RATE = 921_600
SERIAL_TIMEOUT = 2.0         # วินาที — ถ้าไม่ได้ frame ที่ถูกต้องนานกว่านี้จะแจ้ง error

# รูปแบบ frame ของ Task 3 (task3_esp32_bridge.ino)
INPUT_FS = 42000             # sample rate ที่บอร์ดส่งมา (S/s) ต้องตรงกับ FS_HZ ใน fpga/task3_audio.qsf
PLAY_FS = 16000              # sample rate ตอนกดเล่นเสียง (ตัดเสียงจี่ที่สูงกว่า 8 kHz ออก)
BLOCK_SIZE = 1024            # จำนวน sample ต่อหนึ่งบล็อก
SYNC_BYTES = b"\xAA\x55\x33\xCC"  # 4 ไบต์แรกของทุก frame
FRAME_HEADER_BYTES = 20      # ความยาว header รวม sync (ตามด้วย sample และ checksum 2 ไบต์)
SAMPLE_DTYPE = "<u2"         # uint16 little-endian (ค่า ADC 12-bit)
FLAG_TEST_RAMP = 0x02        # บิตใน flags: FPGA กำลังส่งสัญญาณ ramp ทดสอบ ไม่ใช่เสียงจากไมค์

# ลดเสียงพื้นหลัง (audio_input.reduce_noise) แก้แล้วไม่ต้องเพิ่มเพลงใหม่
NOISE_NFFT = 512             # ขนาดหน้าต่าง STFT
NOISE_PERCENTILE = 20        # ใช้ percentile นี้ของแต่ละความถี่เป็นระดับเสียงพื้นหลัง
NOISE_OVERSUB = 1.5          # ลบเสียงพื้นหลังแรงแค่ไหน (มากขึ้น = เงียบขึ้น แต่เสียงจริงเพี้ยนง่ายขึ้น)
NOISE_FLOOR_DB = -20         # ลดเสียงได้มากสุดกี่ dB
NEAR_GATE_DB = 25            # ช่วงเวลาที่เบากว่าช่วงดังเกินกี่ dB ถือว่าเป็นเสียงไกล

# ตัวกรองเสียงแอร์และสัญญาณรบกวน (audio_input.filter_noise) แก้แล้วไม่ต้องเพิ่มเพลงใหม่
FILTER_LOW = 120             # ตัดเสียงทุ้มต่ำกว่านี้ (Hz) เช่น เสียงลมและฮัมไฟ
FILTER_HIGH = 4000           # ตัดเสียงสูงกว่านี้ (Hz) เช่น เสียงซ่า
FILTER_NOTCH_DB = 10         # ความถี่ที่ดังค้างกว่าข้าง ๆ เกินกี่ dB ถือเป็นเสียงเครื่อง และตัดออก
FILTER_MAX_NOTCH = 8         # ตัดความถี่เฉพาะได้มากสุดกี่จุด

# ---------------------------------------------------------------------
# 3) การอัดเสียงเพื่อค้นหา
# ---------------------------------------------------------------------
RECORD_SECONDS = 8           # ความยาวเสียงที่ฟังก่อนค้นหา (วินาที)
DEFAULT_SOURCE = "serial"    # "serial" = ไมค์ผ่าน FPGA + ESP32, "file" = ไฟล์ทดสอบ

# ---------------------------------------------------------------------
# 4) พารามิเตอร์ Fingerprint (หัวใจของอัลกอริทึม)
#    *** ถ้าแก้ค่าในส่วนนี้ ต้อง "ล้างฐานข้อมูล" แล้วเพิ่มเพลงใหม่ ***
# ---------------------------------------------------------------------
FS = 8000                    # ลด sample rate เหลือ 8 kHz ก่อนวิเคราะห์ (ข้อมูลเพลงสำคัญอยู่ < 4 kHz)
NFFT = 1024                  # ขนาด FFT → ความละเอียดความถี่ = FS/NFFT = 7.8 Hz
HOP = 256                    # ระยะเลื่อนเฟรม → 1 เฟรม = HOP/FS = 32 ms
FREQ_MIN = 300               # สนใจเฉพาะ 300–3800 Hz (ลำโพงมือถือแทบไม่มีเบส)
FREQ_MAX = 3800

PEAK_NEIGHBORHOOD = (15, 9)  # ขนาดพื้นที่หา local maximum (ช่องความถี่, เฟรม)
PEAK_MIN_DB = 10             # จุดยอดต้องดังกว่าค่ากลาง (median) ของ spectrogram อย่างน้อยกี่ dB

FAN_OUT = 10                 # จุดยึด 1 จุดจับคู่กับจุดถัดไปได้กี่จุด
TARGET_DT_MIN = 1            # ช่วงเวลาของจุดคู่ (เฟรม)
TARGET_DT_MAX = 63           # 63 เฟรม ≈ 2 วินาที (ต้องไม่เกิน 63 เพราะเก็บใน 6 บิต)
TARGET_DF_MAX = 100          # ความถี่ของจุดคู่ห่างจากจุดยึดได้ไม่เกินกี่ช่อง (100 × 7.8 ≈ 780 Hz)

# ---------------------------------------------------------------------
# โหมดฮัมเพลง (hum.py) แก้แล้วไม่ต้องเพิ่มเพลงใหม่
# ---------------------------------------------------------------------
HUM_FS = 16000               # sample rate ตอนจับ pitch
HUM_FMIN = 130               # ระดับเสียงต่ำสุดที่จับ (Hz) ต่ำกว่านี้ pitch มักจับเสียงฮัมไฟหรือแอร์แถว 100 Hz
HUM_GATE = 0.2               # ไม่ใช้เฟรมที่เบากว่าสัดส่วนนี้ของช่วงดังที่สุด
HUM_FMAX = 1000              # ระดับเสียงสูงสุดที่จับ (Hz)
HUM_STEP = 0.05              # ความละเอียดของเส้นระดับเสียง (วินาที)
HUM_BEAT = 0.5               # ความยาว 1 จังหวะของทำนองอ้างอิง (วินาที)
HUM_MAX_SHIFT = 7            # ลองเลื่อนคีย์ได้กี่ครึ่งเสียงทั้งขึ้นและลง
HUM_COST_CAP = 3.0           # ค่าคลาดสูงสุดต่อเฟรมที่นับ (ครึ่งเสียง)
HUM_MIN_VOICED_SEC = 2.0     # ต้องจับเสียงฮัมได้อย่างน้อยกี่วินาที
HUM_MIN_RANGE = 2.0          # เสียงฮัมต้องขึ้นลงอย่างน้อยกี่ครึ่งเสียง
HUM_MIN_SIMILARITY = 75      # ความคล้ายขั้นต่ำ (0-100) ที่จะตอบว่าเจอเพลง
HUM_MIN_MARGIN = 8           # ต้องห่างจากเพลงอันดับ 2 อย่างน้อยเท่านี้

# ---------------------------------------------------------------------
# 5) การตัดสินผล
# ---------------------------------------------------------------------
# ตอบว่า "เจอเพลง" ก็ต่อเมื่อผ่านทั้ง 2 เงื่อนไข
MIN_MATCHES = 12             # 1) จำนวน hash ที่ offset ตรงกัน ต้องไม่น้อยกว่านี้
MIN_RATIO = 2.5              # 2) คะแนนอันดับ 1 ต้องมากกว่าคะแนน "คู่แข่ง" อย่างน้อยกี่เท่า
                             #    (เพลงที่ไม่มีในฐานข้อมูลมักได้ ratio ≈ 1–1.6)
SONG_REPEATS = 4             # ยอดสูงใน histogram ของเพลงเดียวกันที่ไม่นับเป็นคู่แข่ง (ท่อนซ้ำในเพลง)
