lolheropro-arch/lab_ii_signal/mini_project/melodies.py

"""
melodies.py — ทำนองอ้างอิงของโหมดฮัมเพลง
=====================================================================
แต่ละเพลงคือรายการ (โน้ต MIDI, ความยาวเป็นจังหวะ)  เช่น 60 = C4, 69 = A4
ทำนองพิมพ์เองจากท่อนที่คนจำได้ ถ้าเพิ่มเพลงใหม่ให้เพิ่มที่นี่
ชื่อเพลงใช้แสดงผลเท่านั้น ไม่ต้องตรงกับฐานข้อมูล fingerprint
"""

MELODIES = {
    "Beethoven - Für Elise": [
        (76, .5), (75, .5), (76, .5), (75, .5), (76, .5), (71, .5), (74, .5), (72, .5), (69, 1.5),
        (60, .5), (64, .5), (69, .5), (71, 1.5),
        (64, .5), (68, .5), (71, .5), (72, 1.5),
        (64, .5), (76, .5), (75, .5), (76, .5), (75, .5), (76, .5), (71, .5), (74, .5), (72, .5), (69, 1.5),
        (60, .5), (64, .5), (69, .5), (71, 1.5),
        (64, .5), (72, .5), (71, .5), (69, 1.5),
    ],
    "Mozart - Eine Kleine Nachtmusik": [
        (79, 1), (74, .5), (79, 1), (74, .5),
        (79, .5), (74, .5), (79, .5), (83, .5), (86, 1.5),
        (84, 1), (81, .5), (84, 1), (81, .5),
        (84, .5), (81, .5), (78, .5), (81, .5), (74, 1.5),
        (79, 1), (79, .5), (79, .5), (83, .5), (81, .5), (79, .5), (79, .5), (78, 1),
        (78, .5), (78, .5), (81, .5), (84, .5), (78, .5), (81, .5), (79, 1),
    ],
    "สามัคคีชุมนุม (Auld Lang Syne)": [
        (60, 1), (65, 1.5), (65, .5), (65, 1), (69, 1),
        (67, 1.5), (65, .5), (67, 1), (69, 1),
        (65, 1.5), (65, .5), (69, 1), (72, 1), (74, 3),
        (74, 1), (72, 1.5), (69, .5), (69, 1), (65, 1),
        (67, 1.5), (65, .5), (67, 1), (69, 1),
        (65, 1.5), (62, .5), (62, 1), (60, 1), (65, 3),
    ],
    "เพลงอวยพรวันเกิด (Happy Birthday)": [
        (67, .75), (67, .25), (69, 1), (67, 1), (72, 1), (71, 2),
        (67, .75), (67, .25), (69, 1), (67, 1), (74, 1), (72, 2),
        (67, .75), (67, .25), (79, 1), (76, 1), (72, 1), (71, 1), (69, 2),
        (77, .75), (77, .25), (76, 1), (72, 1), (74, 1), (72, 2),
    ],
}
