lolheropro-arch/lab_ii_signal/(commit log)

2026-11-01 Share one MATLAB scope for Tasks 1-2, document DMA and ping-pong buffering
    - Move realtime_audio_scope.m to matlab/ (used by both Task 1 and Task 2)
    - Put task1_adc_mic.ino in its own sketch folder (required by Arduino IDE)
    - Remove legacy inmp441_stream/inmp441_viewer (different frame format)
    - Rewrite README: usage, frame format, DMA and ping-pong explanation
2026-11-02 Read Task 3 serial frames in Mini Shazam
    record_serial() expected AA 55 plus raw samples at 2 Mbaud, but the
    Task 3 bridge sends 2070-byte frames at 921600 baud. Parsing them that
    way mixed header bytes into the audio and dropped the last samples of
    every block without raising an error.
    Validate sync, length and checksum, fill lost blocks using seq so
    fingerprint timing does not shift, and reject the FPGA test ramp.
    Keep DTR/RTS deasserted so opening the port does not reset the ESP32.
    [audio_input.py, config.py]
2026-11-02 Realign Task 3 SPI stream on the ESP32
    The FPGA stream arrives one bit early, so the 0xC3 status byte reads as
    0x86 and every block was rejected silently. Shift the buffer back when
    that pattern appears. The hardware cause is not scope-confirmed yet.
    Lower SPI to 1 MHz, the speed this fix was tested at, and report link
    state over serial when no valid frame arrives for one second.
    [task3_esp32_bridge.ino]
2026-11-03 Add playback and noise reduction to Mini Shazam
    Add a button that plays the last recording and a checkbox that reduces
    stationary background and quiet passages before playback and matching.
    One microphone cannot measure distance, so loudness stands in for it.
    The checkbox stays off by default because it only helped clearly at
    -10 dB SNR in simulated room noise.
    Fix issues found while testing on the board:
    - Stop counting repeated sections of the top song as rival matches.
    Eine Kleine Nachtmusik matched at two offsets and was rejected.
    - List USB ports first, since the GUI defaults to the first port and
    /dev/ttyS* fails to open with an input/output error.
    - Make the left panel and song l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
    [app.py, audio_input.py, config.py, database.py]
2026-11-04 Give Mini Shazam its own hardware code at 32 kS/s
    Copy the working Quartus project and ESP32 sketch into mini_project so
    they can change without touching Task 3.
    Sample at 32 kS/s. The circuit has no analog anti-aliasing filter, and
    at 16 kS/s interference near 13.7 kHz folds to about 2.3 kHz, inside the
    fingerprint band. At 32 kS/s the quiet 2-3.8 kHz band drops from about
    7.4-8.4 to 2.3-2.6 rms. 40 kS/s only moved the folded tones, so it was
    not adopted.
    Resample to 16 kHz for playback. The sketch sets FS_NOMINAL to 32000,
    which only affects a header field Mini Shazam does not read.
    [audio_block_buffer.vhd, audio_input.py, config.py, de10lite_audio_top.vhd, max10_adc_sampler.vhd, mcp3202_reader.vhd, sample_tick_gen.vhd, spi_slave_block.vhd]
2026-11-04 Raise Mini Shazam sampling to 42 kS/s
    A blind listening test preferred 42 kS/s over 32 kS/s, with less audible
    buzz, and a phone recording of Fur Elise matched with a score of 1065
    and a ratio of 8.1. The two recordings differed in level, and quiet
    measurements at the two rates were nearly equal, so this rests mainly
    on the listening result.
    42 kS/s uses about 85 kB/s of the roughly 92 kB/s available at 921600
    baud, so USB headroom is small. The sketch sets FS_NOMINAL to 42000,
    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
    [config.py, task3_esp32_bridge.ino]
2026-11-04 Add candidate compare, hum mode and noise filter to Mini Shazam
    The GUI's right panel now scrolls, lets you pick a candidate song to
    compare and plays the matching section. A prototype hum mode matches
    pitch contours against reference melodies, and an optional filter cuts
    steady machine noise. Also adds the brief used to write the slides.
    [app.py, audio_input.py, config.py, database.py, hum.py, melodies.py]
2026-11-05 Keep song copies in songs/ and flag missing audio files in Mini Shazam
    Adding a song that is already in the database now copies its audio into
    songs/ so the "play similar section" button can find it, and the song
    list marks entries whose audio file is missing. Also includes Quartus'
    own reordering of the partition lines in task3_audio.qsf (no setting
    changed).
    [app.py, database.py]
